PicoballoonLabs/Hardware-Resources/ATTRIBUTION.md

# Attribution

Symbols, footprints, templates, the color scheme and 3D models authored by
Noove s.r.o. are released under the MIT Licence (see [LICENSE](LICENSE)).

This repository also contains assets obtained from component suppliers and
third-party sources. These remain the property of their respective owners,
remain subject to their original terms, and are **not** relicensed here. The
MIT Licence applies only to the parts authored by Noove s.r.o.

The libraries were assembled over several years as a working design library,
and the origin of each individual file was not recorded. The table below lists
the known sources by category.

| Asset / library | Source | Terms |
|---|---|---|
| Some footprints in `Picoballoon ICs`, `Picoballoon Passives` and `Picoballoon Mechanical & Misc` (identifiable by a `kicad-footprint-generator` or KiCad library description) | [KiCad official libraries](https://www.kicad.org/libraries/) | CC-BY-SA 4.0 with the KiCad library exception |
| Some footprints and 3D models for LCSC-stocked parts | [EasyEDA / LCSC](https://easyeda.com/) | Original EasyEDA / LCSC terms |
| Some symbols, footprints and 3D models | [SnapMagic Search (SnapEDA)](https://www.snapeda.com/) | Original SnapMagic terms |
| Some symbols, footprints and 3D models | [Component Search Engine (SamacSys)](https://componentsearchengine.com/) | Original SamacSys terms |
| Some 3D models | [GrabCAD Community](https://grabcad.com/library) | Original terms of the respective GrabCAD author |
| 3D models of connectors, ICs and other catalogue parts | The respective component manufacturers (e.g. TE Connectivity, Molex, Hirose, Texas Instruments) and CAD portals such as TraceParts | Original manufacturer terms |
| `ONP1.2-37x54` solar panel model and footprints, power symbols, drawing sheet templates, color scheme, remaining symbols and footprints | Noove s.r.o. | MIT |

## Corrections and removal requests

If you are the owner of an asset in this repository and want it attributed
differently or removed, contact <hello@picoballoon.io> and it will be handled
promptly.
