PicoballoonLabs/Hardware-Resources/QFN-16.stp

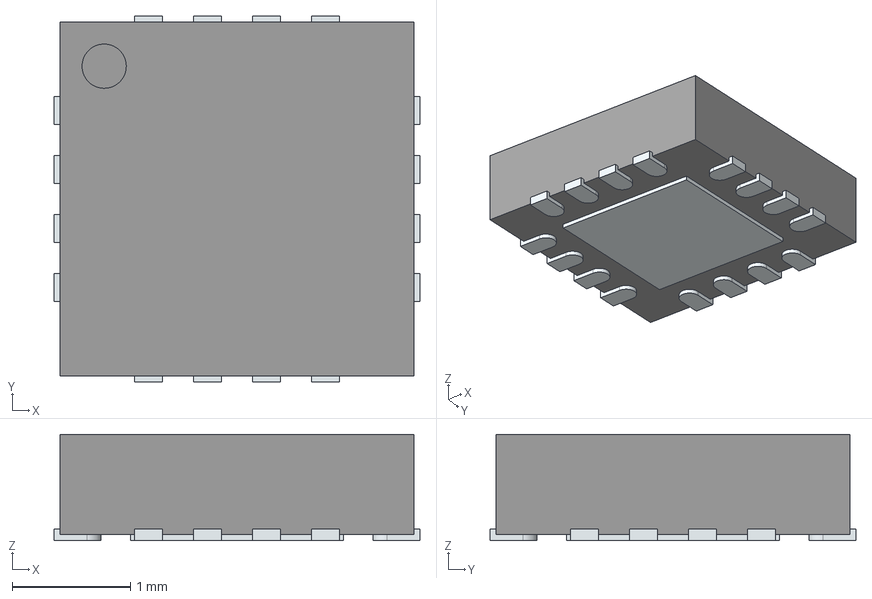
[picture p1: CAD file, 2024-07-15, last stored version]
QFN-16.stp
3.10 x 3.10 x 0.9 mm
ThermalPin
PinsArrayLR
PinsArrayTB
