PicoballoonLabs/Hardware-Resources/3D Models/VSON-HR-10.step

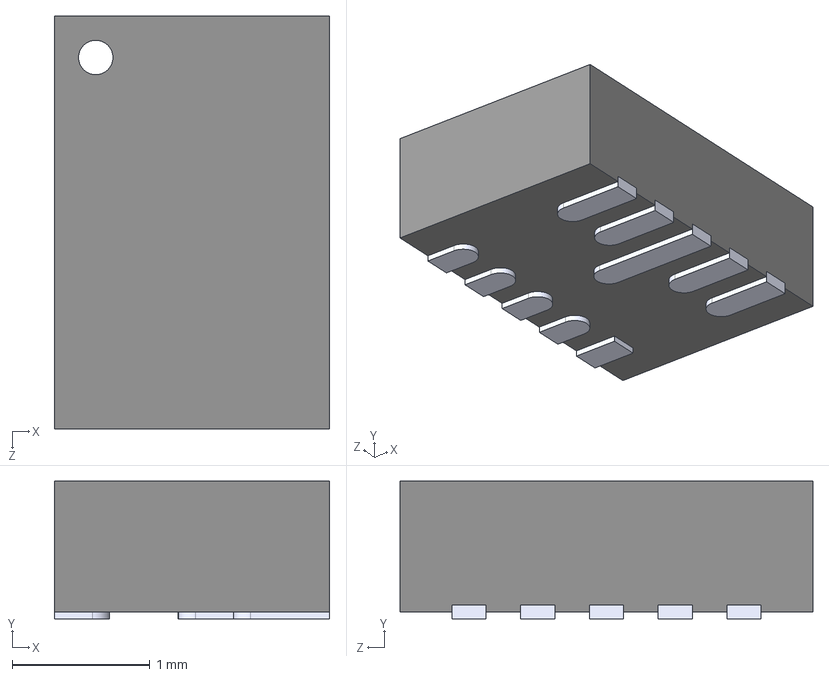
[picture p2: CAD file, 2025-07-29, last stored version]
3D Models/VSON-HR-10.step
2.00 x 1.00 x 3.00 mm
