PicoballoonLabs/Hardware-Resources/3D Models/Inductor 1620.stp

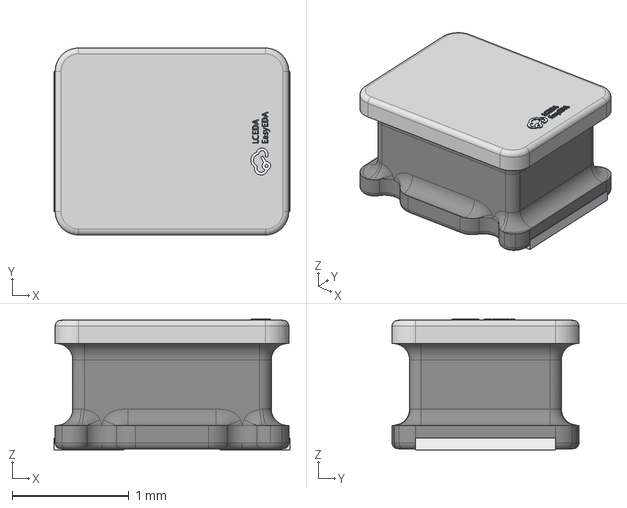
[picture p3: CAD file, 2025-07-29, last stored version]
3D Models/Inductor 1620.stp
2.02 x 1.60 x 1.12 mm
