PicoballoonLabs/Hardware-Resources/3D Models/Polyfuse 2920.STEP

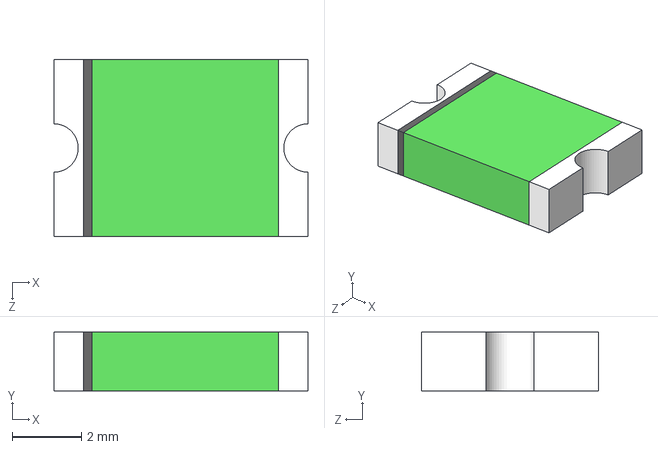
[picture p4: CAD file, 2025-07-21, last stored version]
3D Models/Polyfuse 2920.STEP
7.36 x 1.70 x 5.12 mm
