PicoballoonLabs/Hardware-Resources/3D Models/Polyfuse 1812.STEP

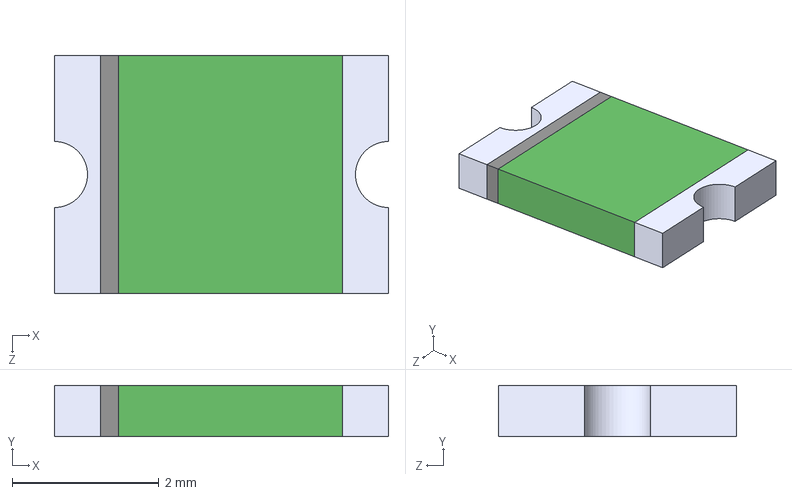
[picture p5: CAD file, 2025-07-21, last stored version]
3D Models/Polyfuse 1812.STEP
4.55 x 0.7 x 3.24 mm
