PicoballoonLabs/Hardware-Resources/3D Models/Fuse 1206.STEP

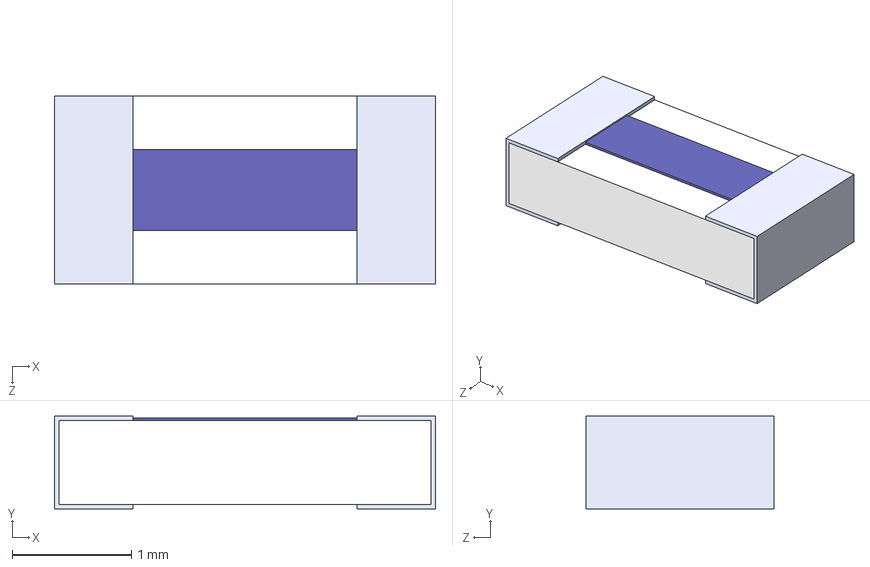
[picture p6: CAD file, 2025-07-21, last stored version]
3D Models/Fuse 1206.STEP
3.20 x 0.78 x 1.58 mm
