PicoballoonLabs/Hardware-Resources/3D Models/HPAK-7.step

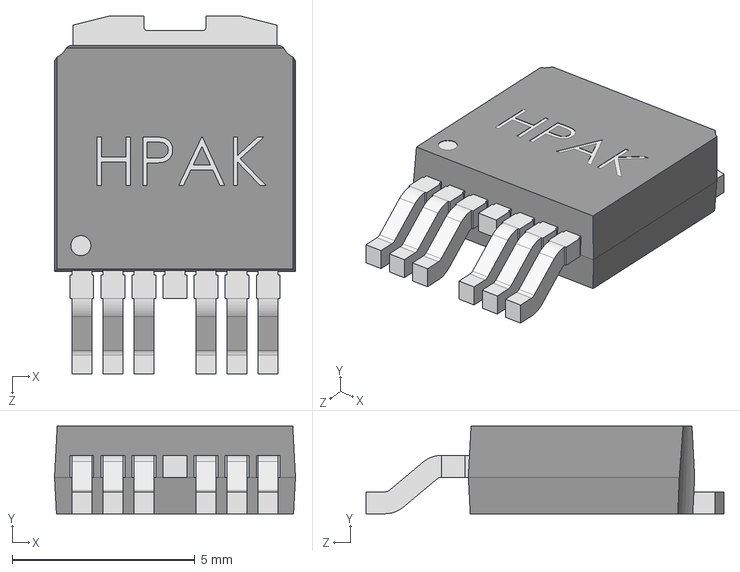
[picture p7: CAD file, 2025-07-18, last stored version]
3D Models/HPAK-7.step
6.60 x 2.40 x 9.80 mm
