PicoballoonLabs/Hardware-Resources/3D Models/WSCP-8.STEP

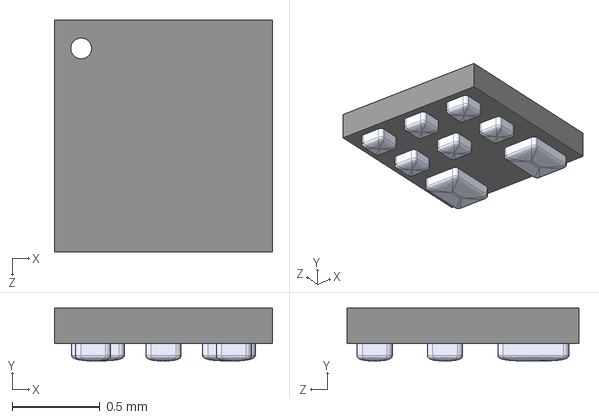
[picture p8: CAD file, 2025-07-18, last stored version]
3D Models/WSCP-8.STEP
1.24 x 0.3 x 1.32 mm
