PicoballoonLabs/Hardware-Resources/3D Models/Inductor 6466.stp

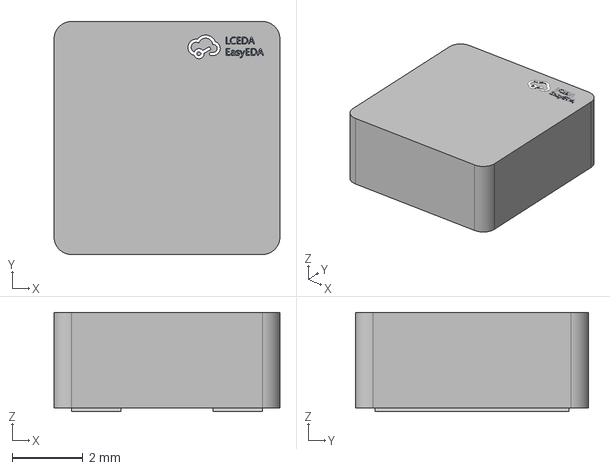
[picture p9: CAD file, 2025-07-18, last stored version]
3D Models/Inductor 6466.stp
6.40 x 6.60 x 2.81 mm
