PicoballoonLabs/Hardware-Resources/3D Models/VQFN-HR-10.step

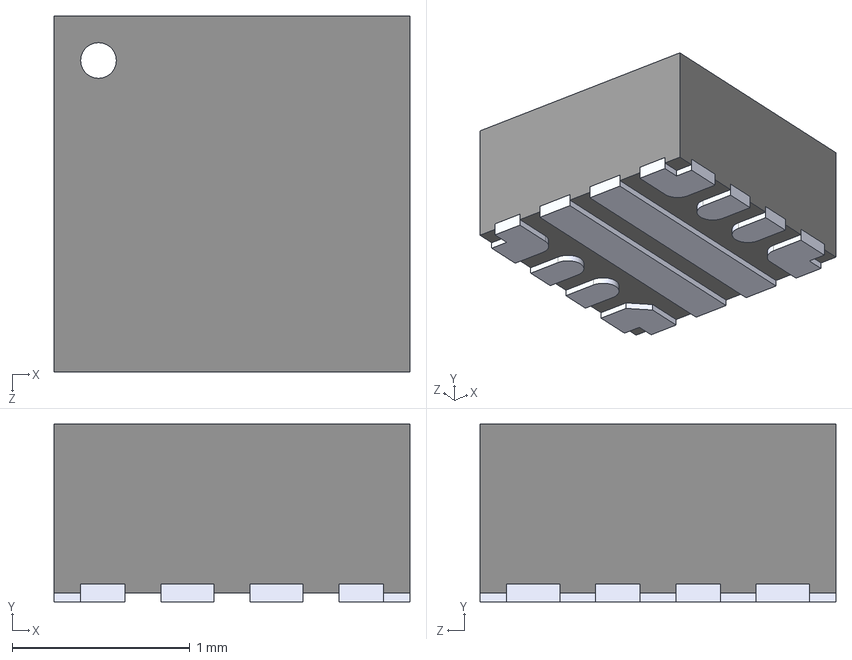
[picture p10: CAD file, 2025-07-18, last stored version]
3D Models/VQFN-HR-10.step
2.00 x 1.00 x 2.00 mm
