PicoballoonLabs/Hardware-Resources/3D Models/VFQFN-HR-11.STEP

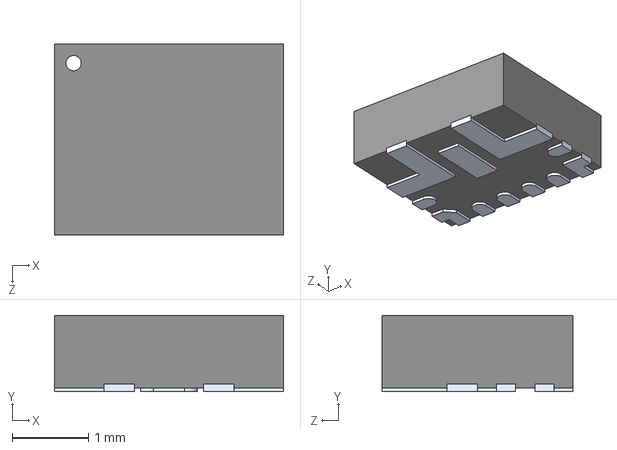
[picture p11: CAD file, 2025-07-18, last stored version]
3D Models/VFQFN-HR-11.STEP
3.00 x 1.00 x 2.50 mm
