PicoballoonLabs/Hardware-Resources/3D Models/Polyfuse 1210.STEP

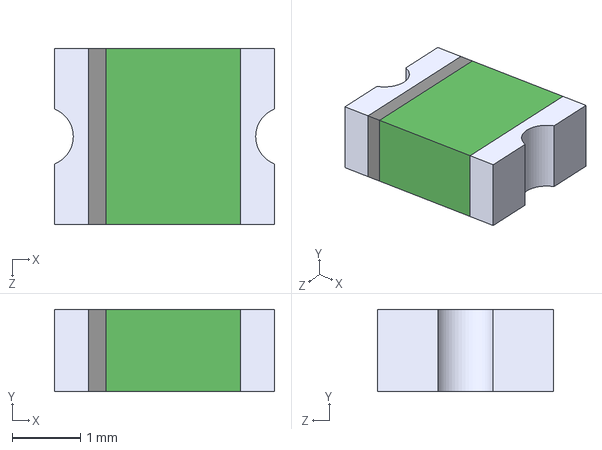
[picture p12: CAD file, 2025-07-18, last stored version]
3D Models/Polyfuse 1210.STEP
3.22 x 1.20 x 2.58 mm
