PicoballoonLabs/Hardware-Resources/3D Models/WAFER-XH2.54-2PWB.stp

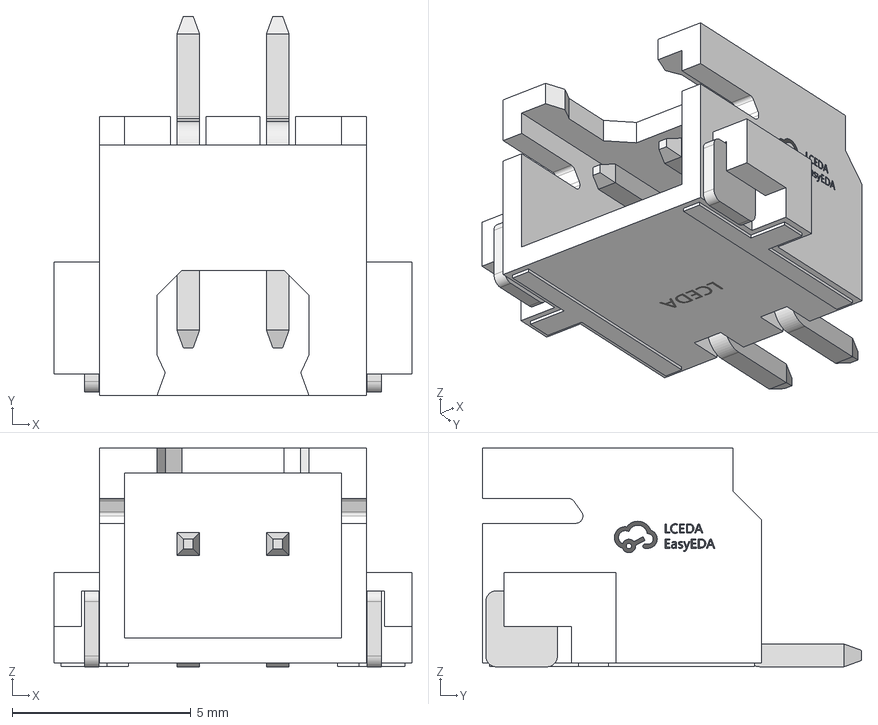
[picture p13: CAD file, 2025-07-18, last stored version]
3D Models/WAFER-XH2.54-2PWB.stp
10.00 x 10.6 x 6.11 mm
