PicoballoonLabs/Hardware-Resources/3D Models/Capacitor 6.3x5.9mm.STEP

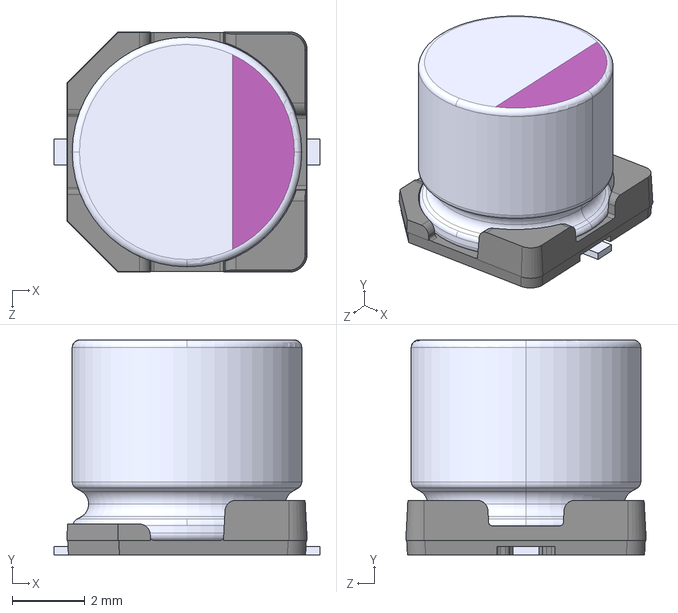
[picture p14: CAD file, 2025-06-23, last stored version]
3D Models/Capacitor 6.3x5.9mm.STEP
7.30 x 5.90 x 6.60 mm
