PicoballoonLabs/Hardware-Resources/3D Models/Polyfuse 2018.stp

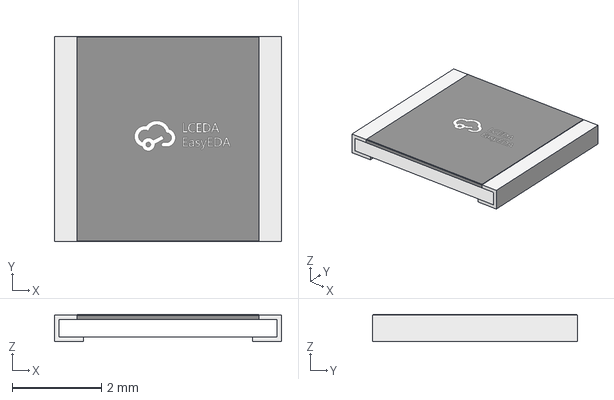
[picture p15: CAD file, 2025-06-23, last stored version]
3D Models/Polyfuse 2018.stp
5.10 x 4.60 x 0.611 mm
