PicoballoonLabs/Hardware-Resources/3D Models/DFN-6 2x2mm.stp

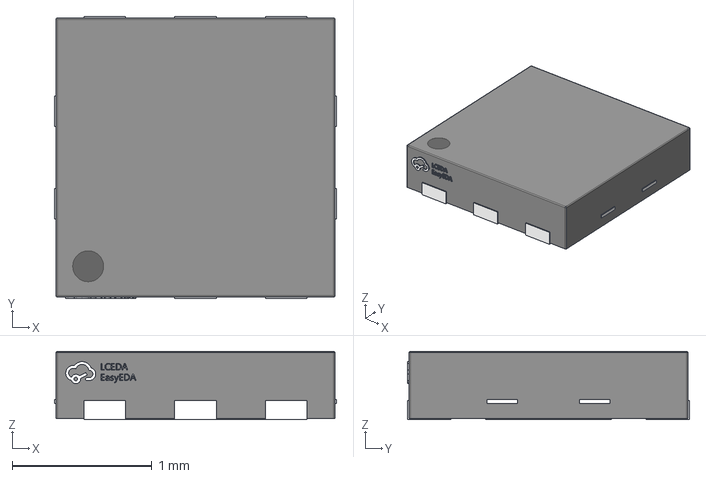
[picture p16: CAD file, 2025-06-23, last stored version]
3D Models/DFN-6 2x2mm.stp
2.02 x 2.02 x 0.49 mm
