PicoballoonLabs/Hardware-Resources/3D Models/QFN-16 4x4mm.step

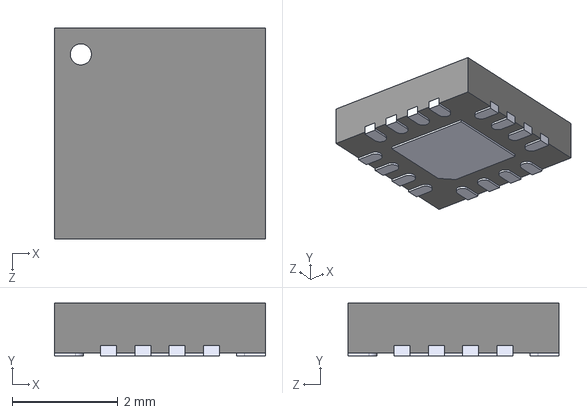
[picture p17: CAD file, 2025-06-23, last stored version]
3D Models/QFN-16 4x4mm.step
4.00 x 1.00 x 4.00 mm
