PicoballoonLabs/Hardware-Resources/3D Models/DC-005-5A-2.5-SMT.stp

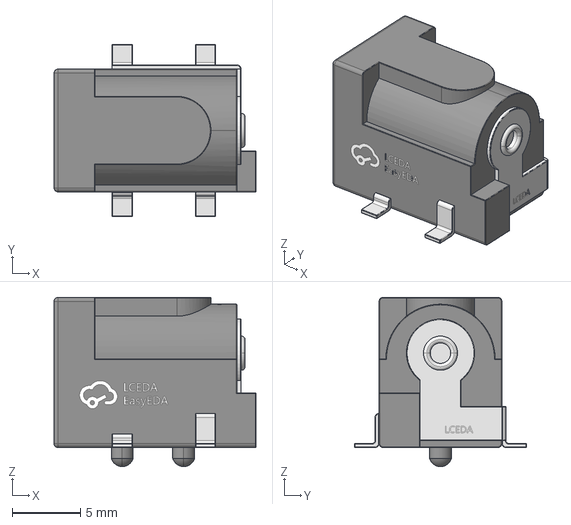
[picture p18: CAD file, 2025-06-23, last stored version]
3D Models/DC-005-5A-2.5-SMT.stp
14.8 x 12.6 x 12.4 mm
