PicoballoonLabs/Hardware-Resources/3D Models/WS2812B-MINI-X2.stp

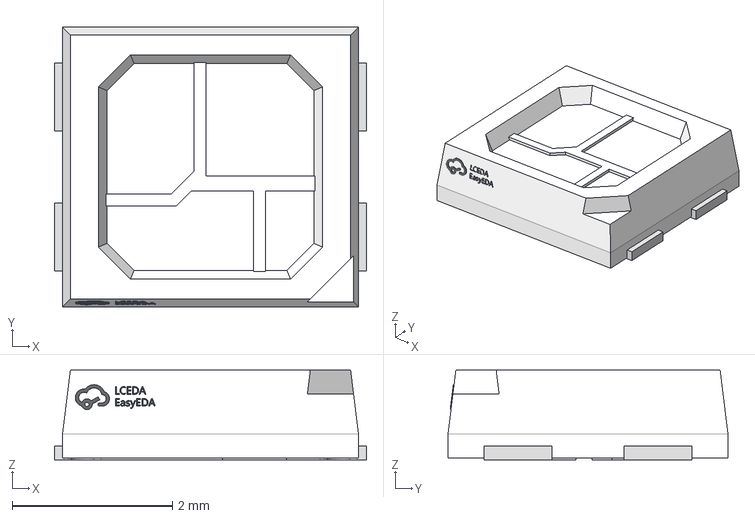
[picture p19: CAD file, 2025-06-23, last stored version]
3D Models/WS2812B-MINI-X2.stp
3.90 x 3.50 x 1.12 mm
