PicoballoonLabs/Hardware-Resources/3D Models/Polyfuse 1206.STEP

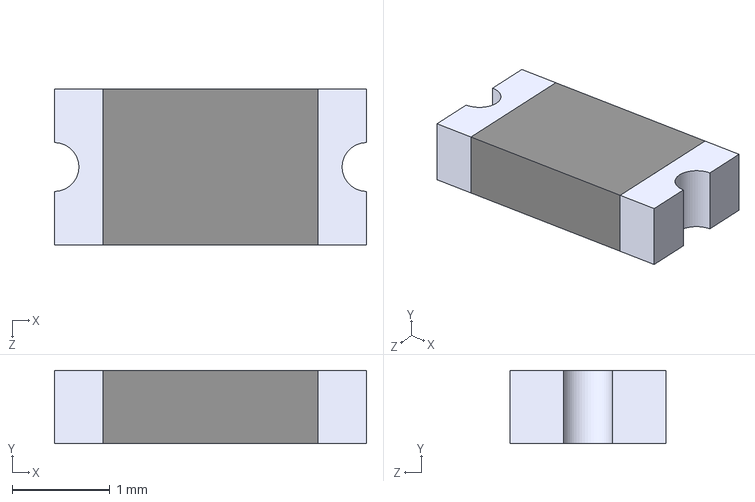
[picture p20: CAD file, 2025-06-23, last stored version]
3D Models/Polyfuse 1206.STEP
3.20 x 0.75 x 1.60 mm
