PicoballoonLabs/Hardware-Resources/3D Models/Inductor 5553.stp

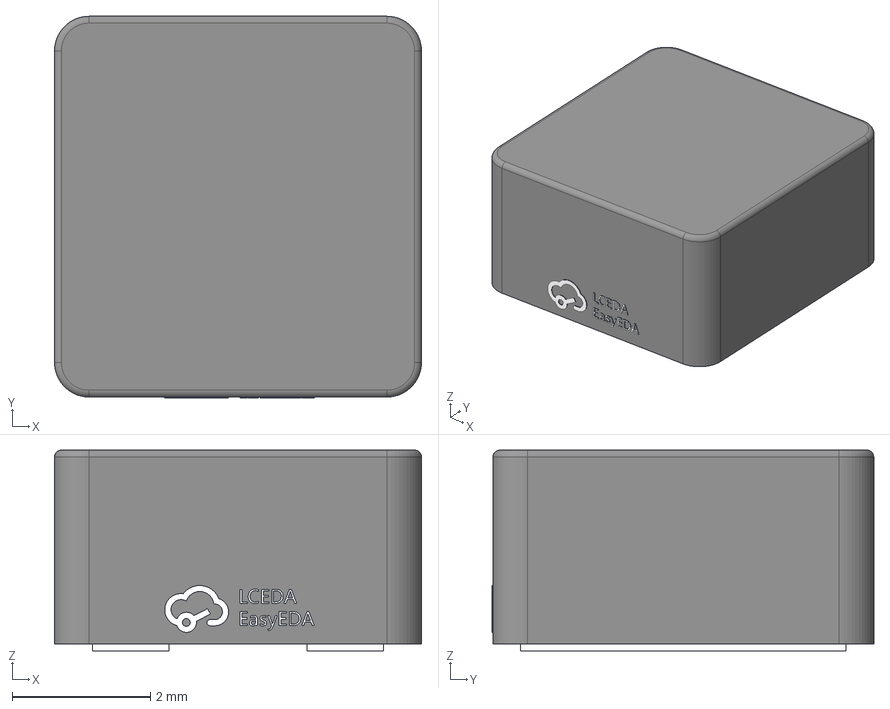
[picture p21: CAD file, 2025-06-23, last stored version]
3D Models/Inductor 5553.stp
5.30 x 5.51 x 2.90 mm
