PicoballoonLabs/Hardware-Resources/3D Models/Inductor 3x3mm.stp

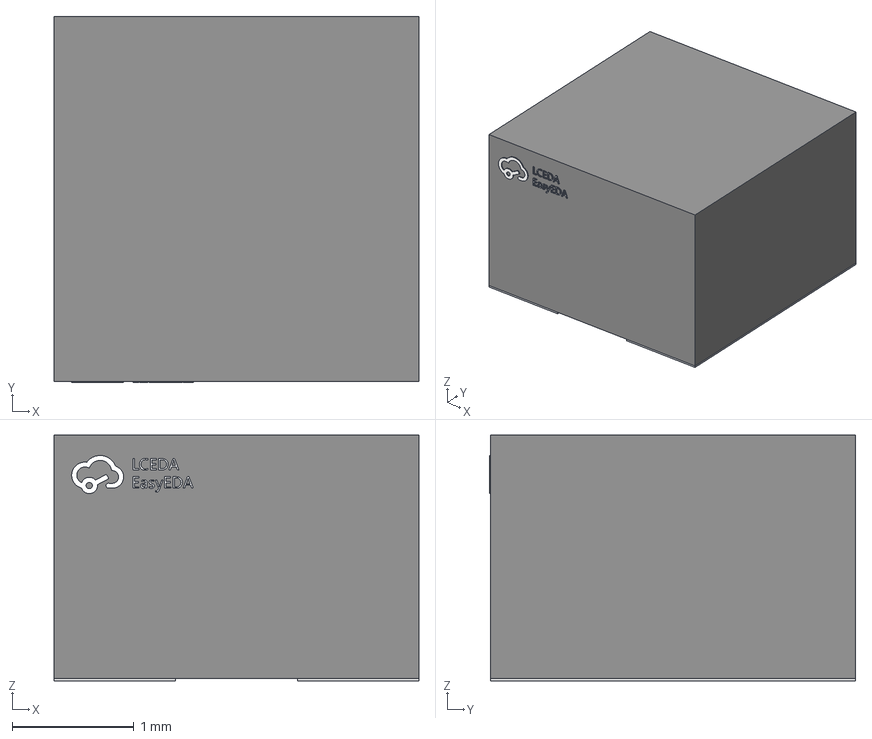
[picture p22: CAD file, 2025-04-17, last stored version]
3D Models/Inductor 3x3mm.stp
3.00 x 3.01 x 2.02 mm
