PicoballoonLabs/Hardware-Resources/3D Models/XT60PW-F.STEP

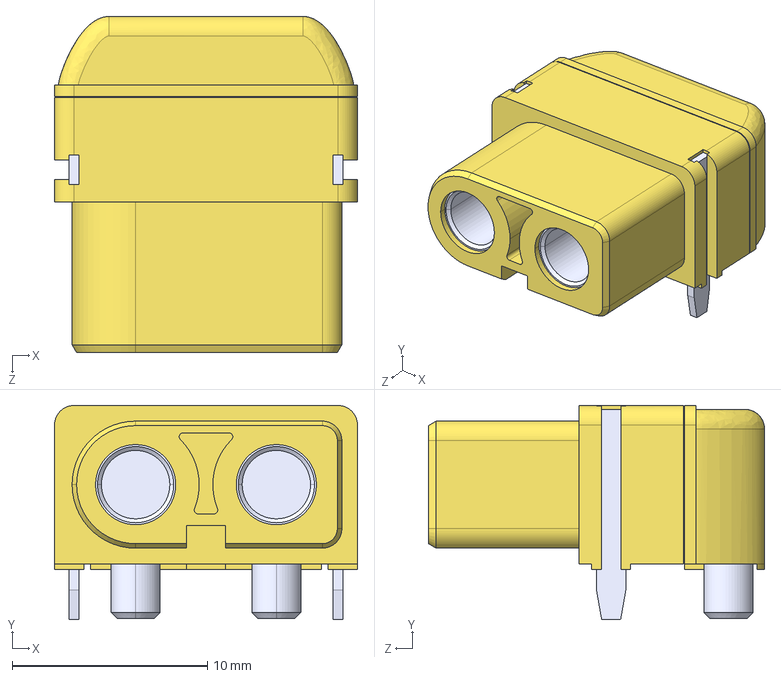
[picture p23: CAD file, 2025-04-14, last stored version]
3D Models/XT60PW-F.STEP
15.5 x 10.9 x 17.2 mm
