PicoballoonLabs/Hardware-Resources/3D Models/B2B YXT-BB10-10P-02.stp

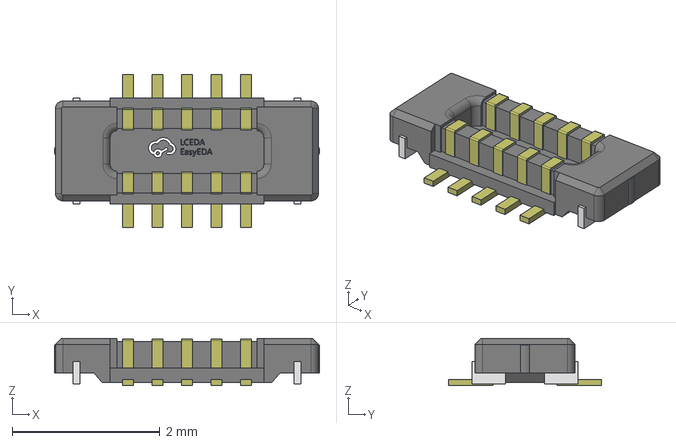
[picture p24: CAD file, 2025-04-09, last stored version]
3D Models/B2B YXT-BB10-10P-02.stp
3.59 x 2.07 x 0.64 mm
