PicoballoonLabs/Hardware-Resources/3D Models/Inductor 1008.stp

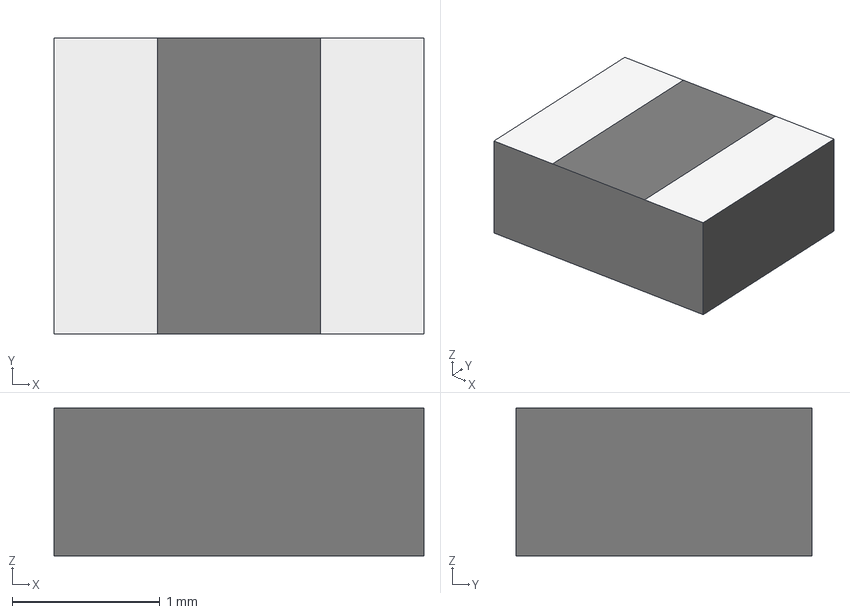
[picture p26: CAD file, 2025-04-09, last stored version]
3D Models/Inductor 1008.stp
2.50 x 2.00 x 1.00 mm
body_SSMC_252010
land_pattern_SSMC_252010 x 2
