PicoballoonLabs/Hardware-Resources/3D Models/B2B GT-B0353MSV04-06B0201.stp

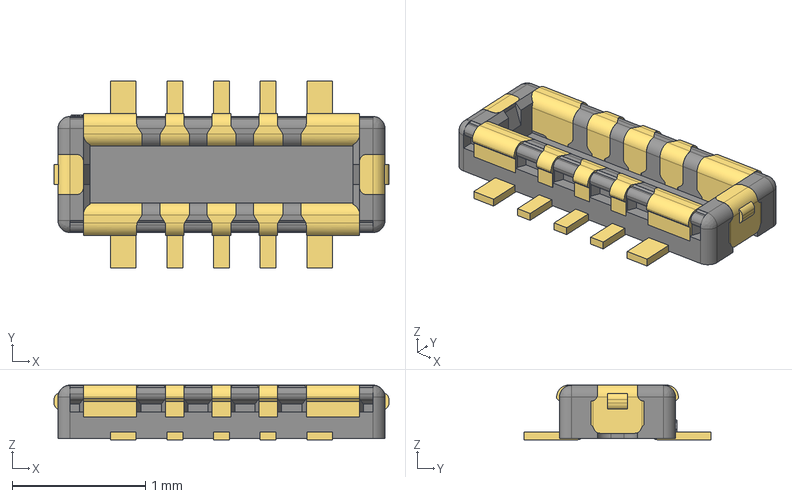
[picture p27: CAD file, 2025-04-09, last stored version]
3D Models/B2B GT-B0353MSV04-06B0201.stp
2.51 x 1.40 x 0.411 mm
