PicoballoonLabs/Hardware-Resources/3D Models/B2B GT-B0353FSV06-08B0201.stp

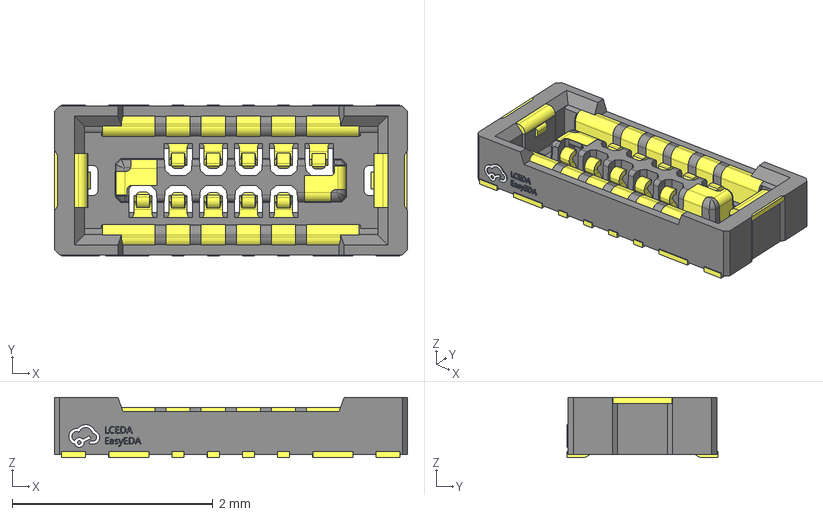
[picture p28: CAD file, 2025-04-07, last stored version]
3D Models/B2B GT-B0353FSV06-08B0201.stp
3.51 x 1.50 x 0.601 mm
