PicoballoonLabs/Hardware-Resources/3D Models/MOLEX 532610271.STEP

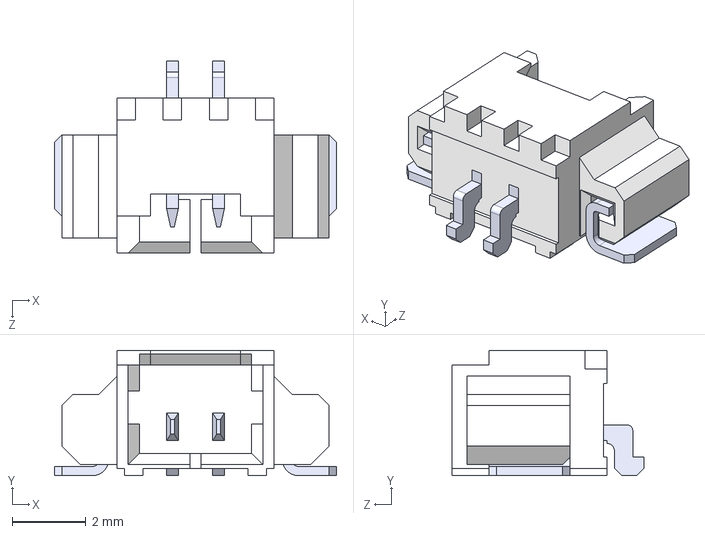
[picture p29: CAD file, 2025-04-07, last stored version]
3D Models/MOLEX 532610271.STEP
7.65 x 3.40 x 5.20 mm
