PicoballoonLabs/Hardware-Resources/3D Models/B2B GT-B0353FSV06-06B0201.stp

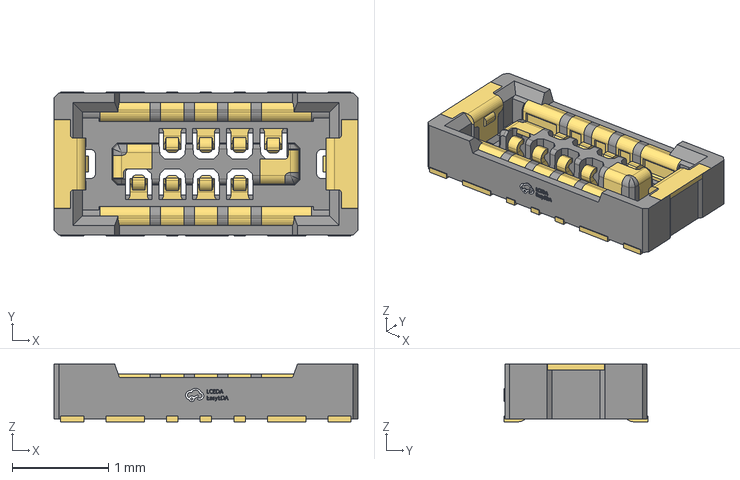
[picture p30: CAD file, 2025-04-07, last stored version]
3D Models/B2B GT-B0353FSV06-06B0201.stp
3.16 x 1.50 x 0.6 mm
