PicoballoonLabs/Hardware-Resources/3D Models/FPC-05F-10PH20.stp

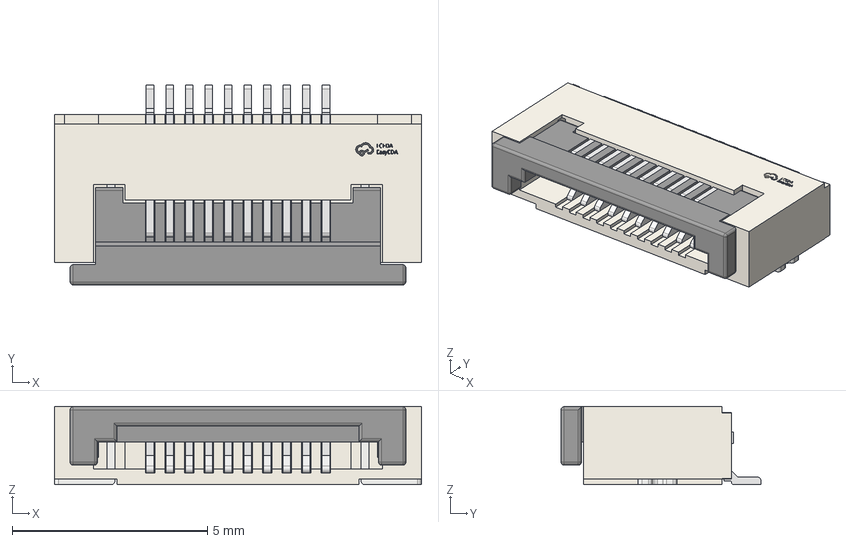
[picture p31: CAD file, 2025-04-07, last stored version]
3D Models/FPC-05F-10PH20.stp
9.40 x 5.12 x 2.01 mm
