PicoballoonLabs/Hardware-Resources/3D Models/B2B YXT YXT-BB10-10S-02.STEP

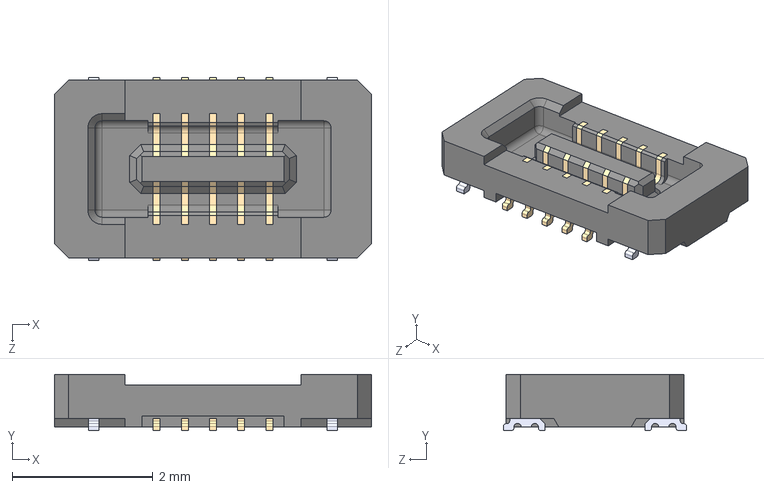
[picture p32: CAD file, 2025-04-07, last stored version]
3D Models/B2B YXT YXT-BB10-10S-02.STEP
4.50 x 0.8 x 2.60 mm
