PicoballoonLabs/Hardware-Resources/3D Models/Inductor 7678.stp

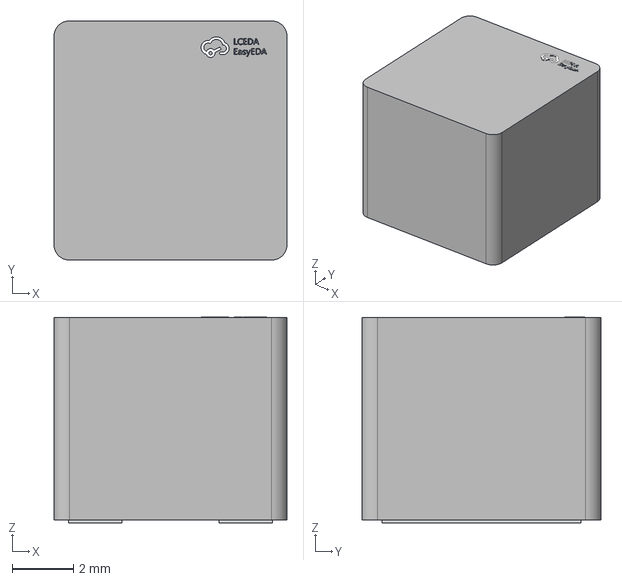
[picture p33: CAD file, 2025-04-04, last stored version]
3D Models/Inductor 7678.stp
7.60 x 7.80 x 6.71 mm
