PicoballoonLabs/Hardware-Resources/3D Models/VQFN-11.STEP

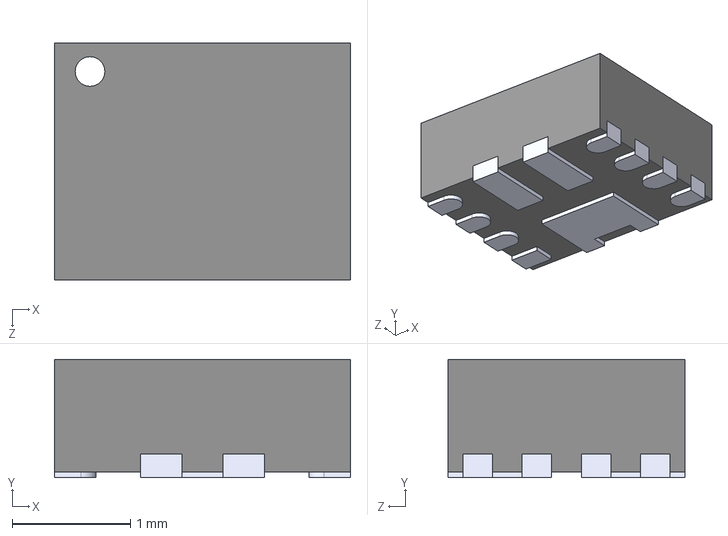
[picture p34: CAD file, 2025-04-04, last stored version]
3D Models/VQFN-11.STEP
2.50 x 1.00 x 2.00 mm
