PicoballoonLabs/Hardware-Resources/3D Models/LED WS2816B-2121.STEP

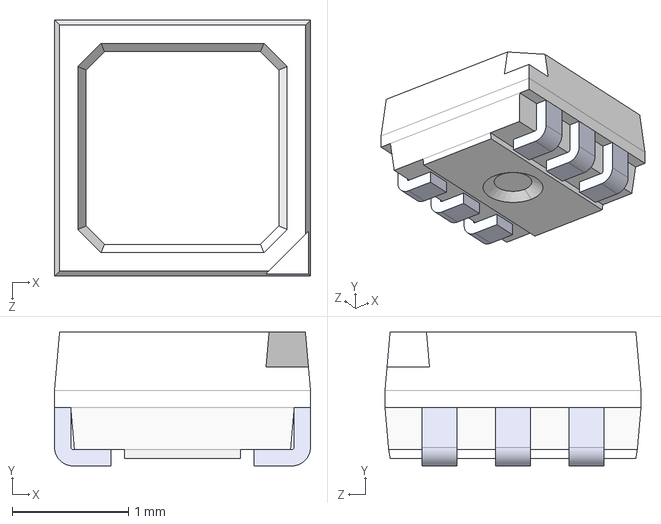
[picture p35: CAD file, 2025-04-03, last stored version]
3D Models/LED WS2816B-2121.STEP
2.20 x 1.15 x 2.20 mm
