PicoballoonLabs/Hardware-Resources/3D Models/Button GT_TC029B-H025-L1N.stp

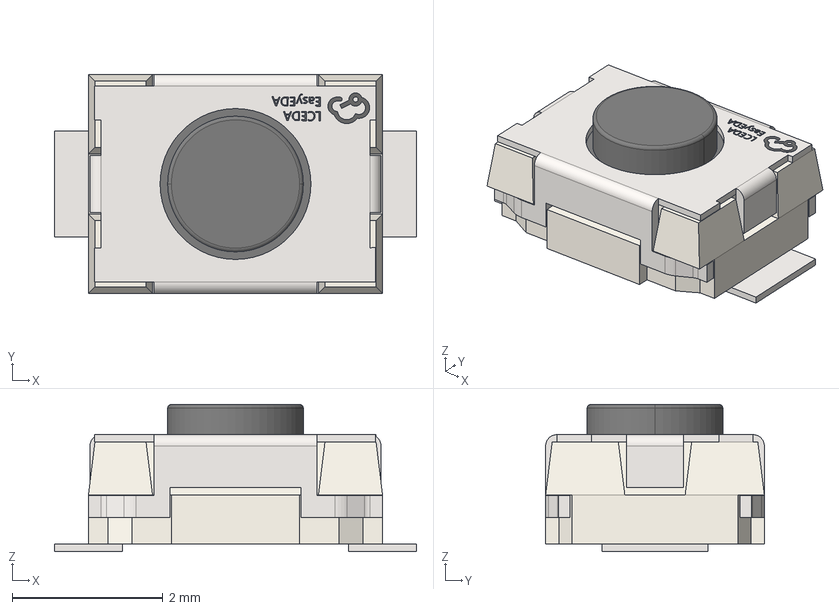
[picture p36: CAD file, 2025-04-03, last stored version]
3D Models/Button GT_TC029B-H025-L1N.stp
4.80 x 2.90 x 1.95 mm
