PicoballoonLabs/Hardware-Resources/3D Models/LED WS2813B-MINI-V1.STEP

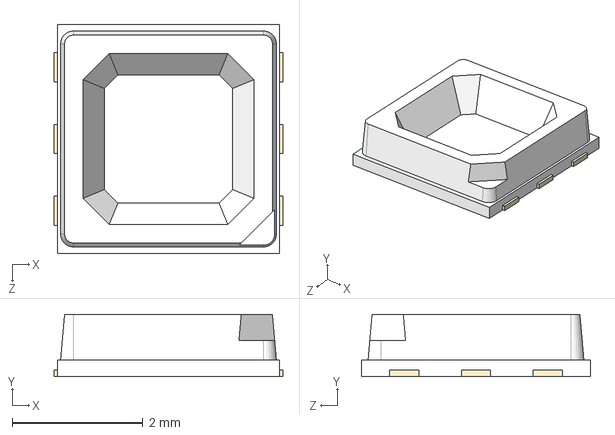
[picture p37: CAD file, 2025-04-03, last stored version]
3D Models/LED WS2813B-MINI-V1.STEP
3.50 x 0.95 x 3.50 mm
