PicoballoonLabs/Hardware-Resources/3D Models/VFQFN-29.STEP

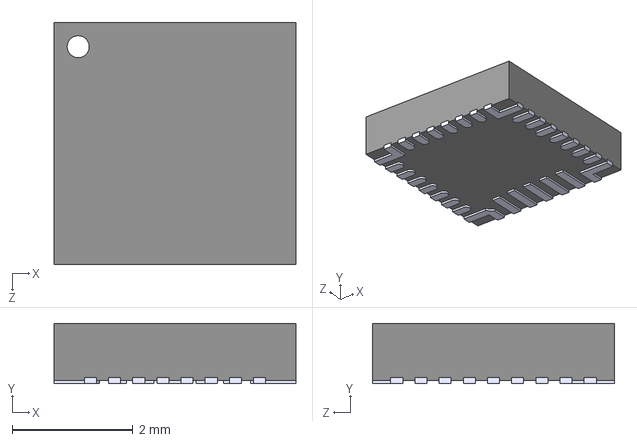
[picture p38: CAD file, 2025-04-03, last stored version]
3D Models/VFQFN-29.STEP
4.00 x 1.00 x 4.00 mm
