PicoballoonLabs/Hardware-Resources/3D Models/Battery holder BH-18650-B1BA002.stp

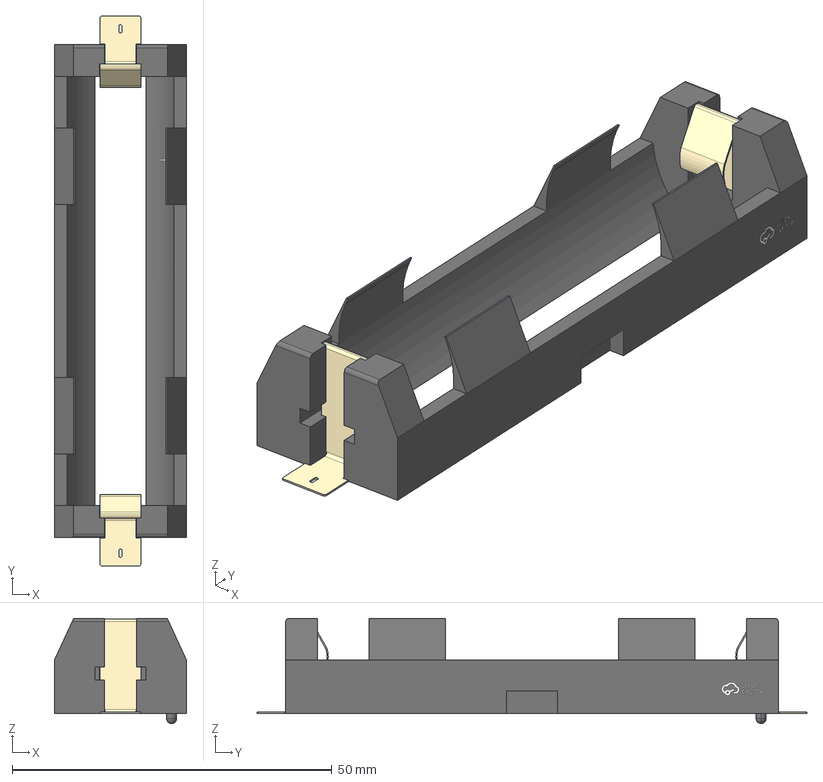
[picture p39: CAD file, 2025-04-03, last stored version]
3D Models/Battery holder BH-18650-B1BA002.stp
20.7 x 86.0 x 16.5 mm
