PicoballoonLabs/Hardware-Resources/3D Models/VSON-10 3x3mm.STEP

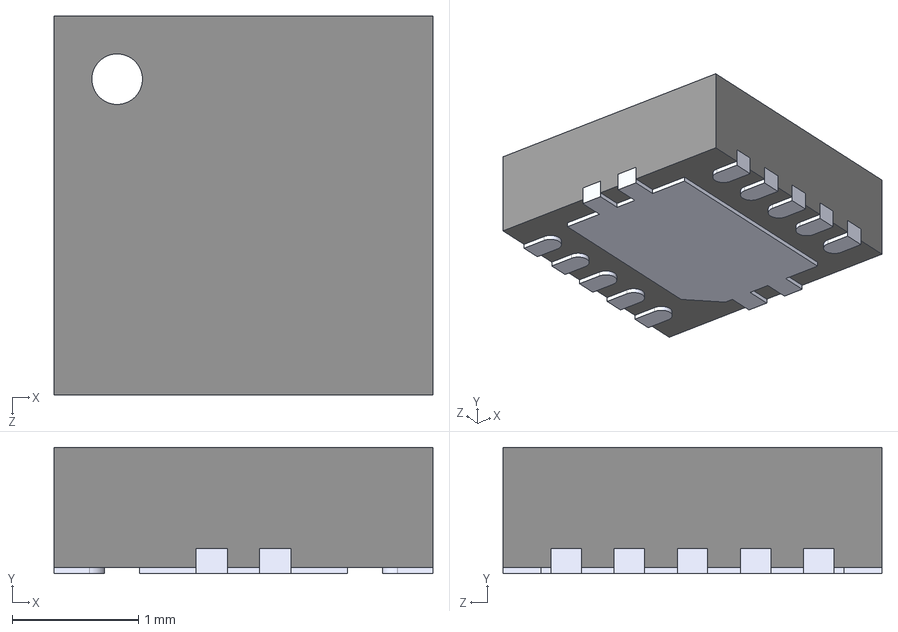
[picture p40: CAD file, 2025-04-03, last stored version]
3D Models/VSON-10 3x3mm.STEP
3.00 x 1.00 x 3.00 mm
