PicoballoonLabs/Hardware-Resources/3D Models/MM8030-2610RK0.step

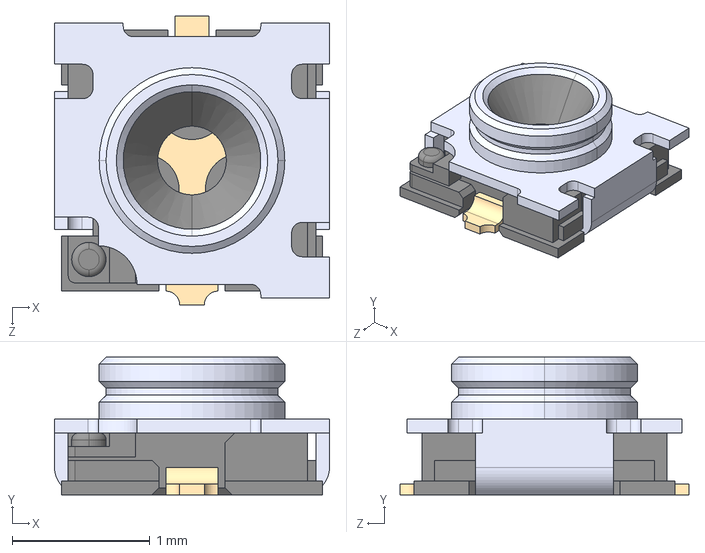
[picture p41: CAD file, 2025-02-13, last stored version]
3D Models/MM8030-2610RK0.step
2.00 x 1.00 x 2.10 mm
