PicoballoonLabs/Hardware-Resources/3D Models/BWSMA-KE-P001.stp

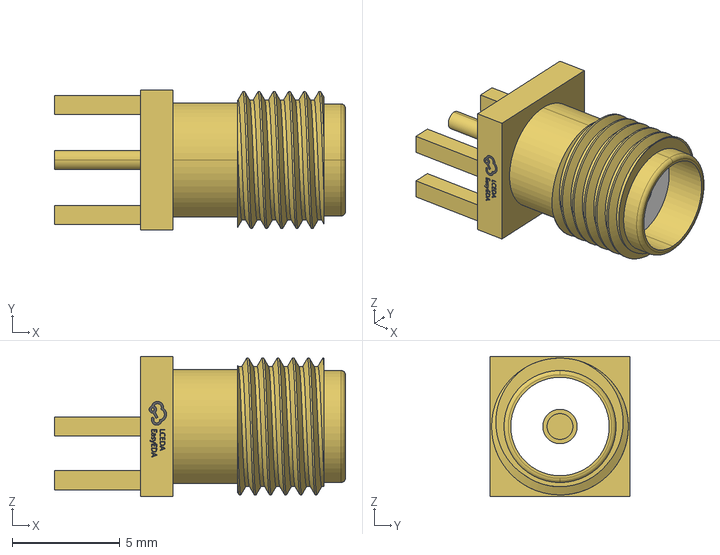
[picture p42: CAD file, 2024-12-27, last stored version]
3D Models/BWSMA-KE-P001.stp
13.5 x 6.50 x 6.50 mm
