PicoballoonLabs/Hardware-Resources/3D Models/SMA_EDGE.step

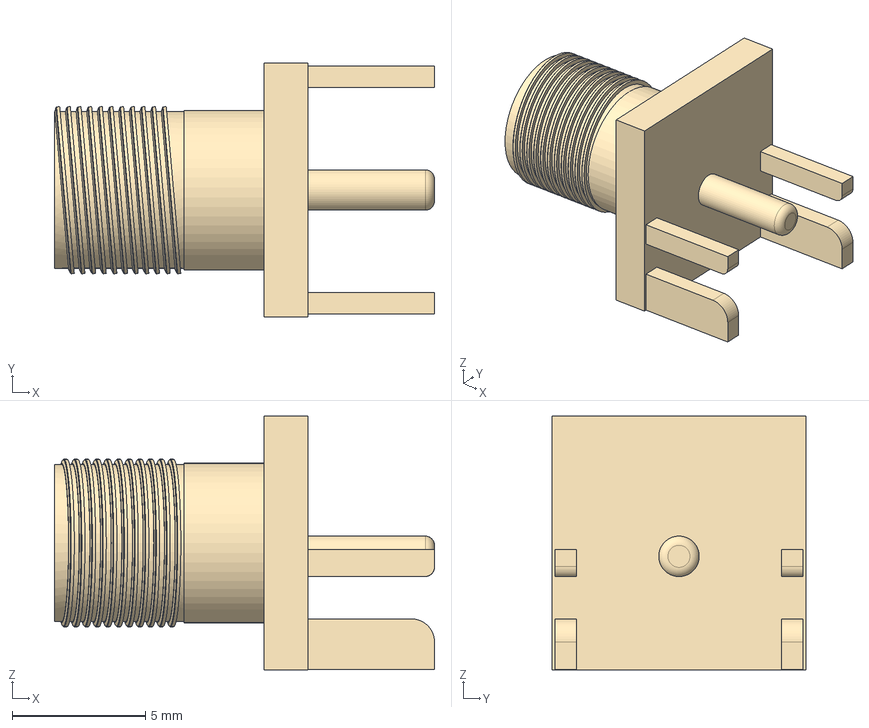
[picture p43: CAD file, 2024-11-05, last stored version]
3D Models/SMA_EDGE.step
14.3 x 9.52 x 9.52 mm
