PicoballoonLabs/Hardware-Resources/3D Models/Diode SMB.step

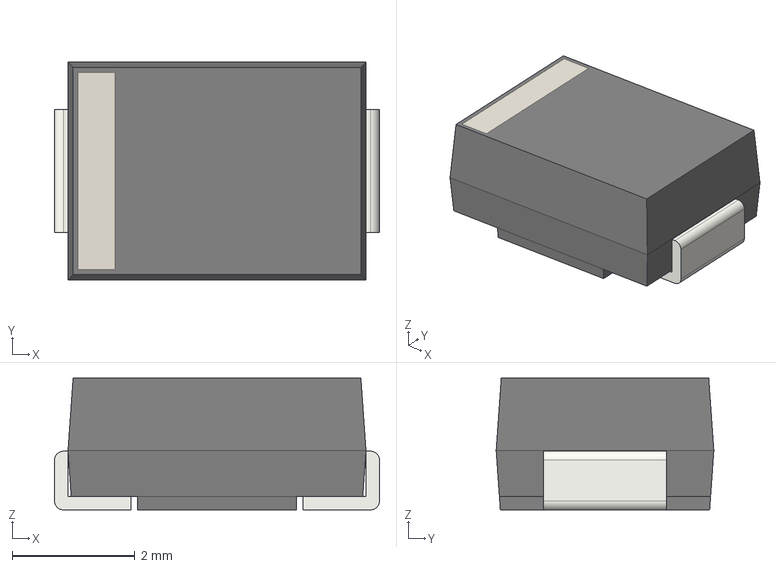
[picture p44: CAD file, 2024-11-05, last stored version]
3D Models/Diode SMB.step
5.30 x 3.55 x 2.15 mm
