PicoballoonLabs/Hardware-Resources/3D Models/WAFER-XH2.54-4PWB.stp

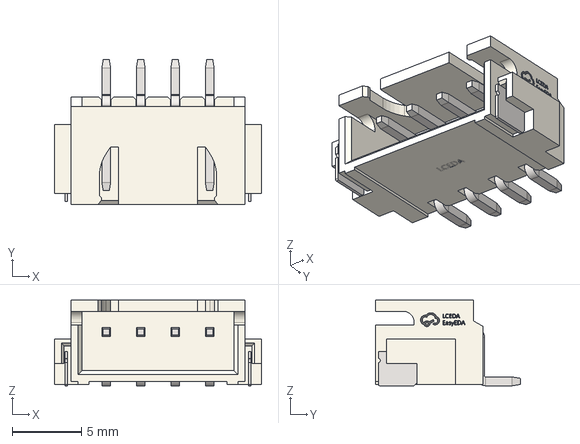
[picture p45: CAD file, 2024-11-05, last stored version]
3D Models/WAFER-XH2.54-4PWB.stp
15.0 x 10.5 x 6.20 mm
