PicoballoonLabs/Hardware-Resources/3D Models/NRF9161.STEP

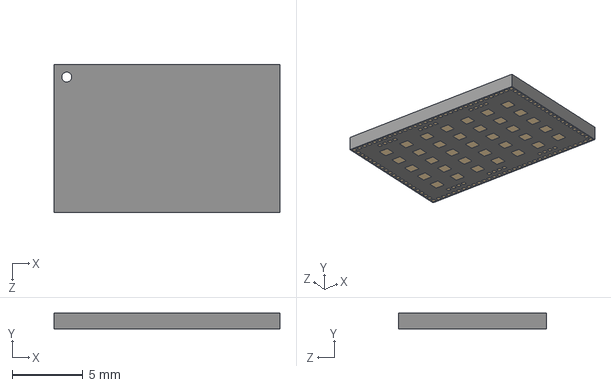
[picture p46: CAD file, 2024-11-04, last stored version]
3D Models/NRF9161.STEP
16.0 x 1.10 x 10.5 mm
