PicoballoonLabs/Hardware-Resources/3D Models/Inductor 0201.STEP

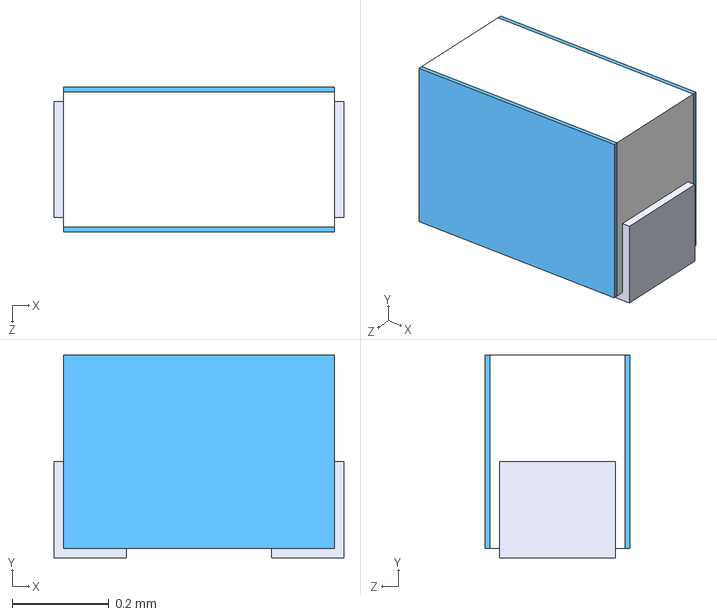
[picture p47: CAD file, 2024-11-04, last stored version]
3D Models/Inductor 0201.STEP
0.6 x 0.42 x 0.3 mm
