PicoballoonLabs/Hardware-Resources/3D Models/X2-DFN1010-3.stp

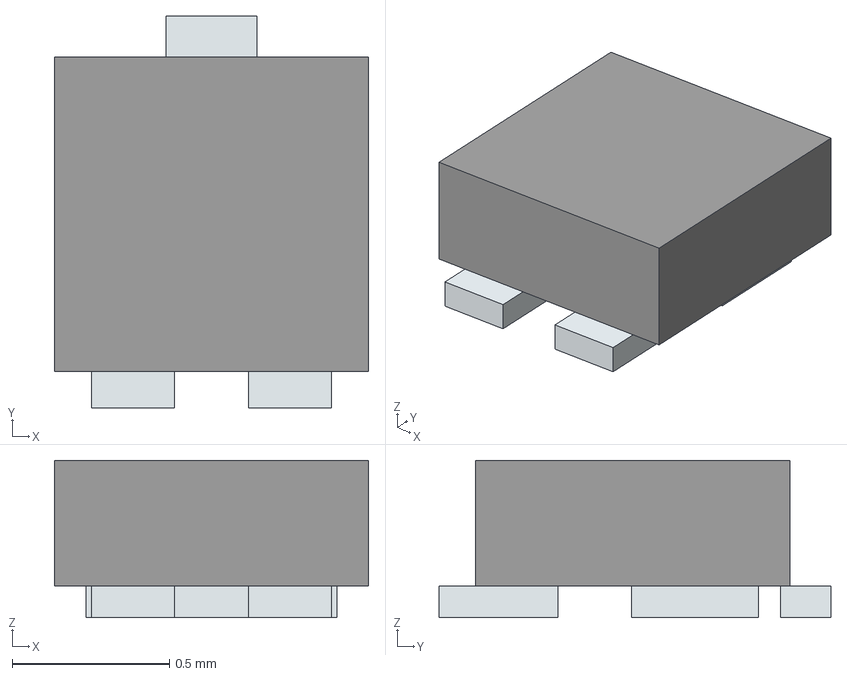
[picture p48: CAD file, 2024-10-10, last stored version]
3D Models/X2-DFN1010-3.stp
1.00 x 1.25 x 0.5 mm
Pins
