PicoballoonLabs/Hardware-Resources/3D Models/SWD 2x5 Box Connector.step

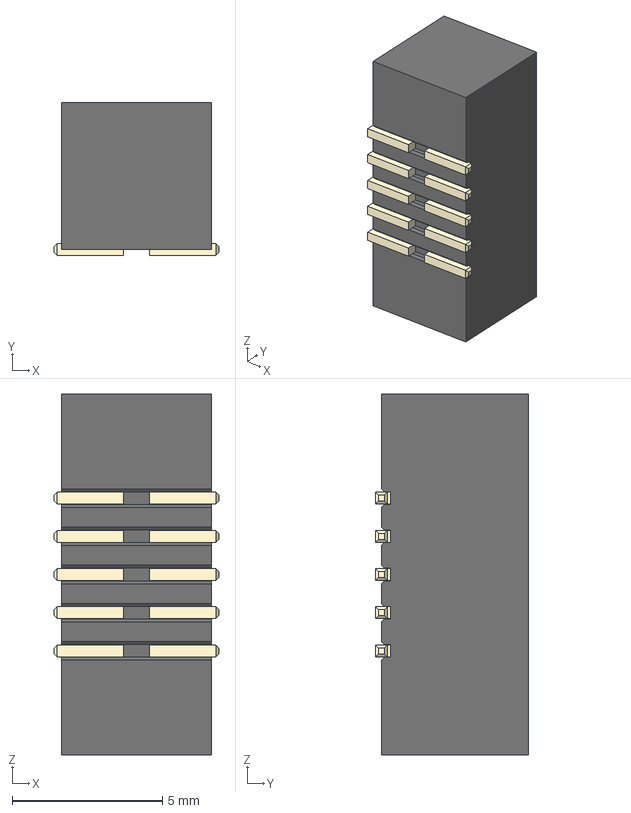
[picture p49: CAD file, 2024-10-08, last stored version]
3D Models/SWD 2x5 Box Connector.step
5.47 x 5.10 x 12.0 mm
