PicoballoonLabs/Hardware-Resources/3D Models/SWD 2x5 Mini Connector.step

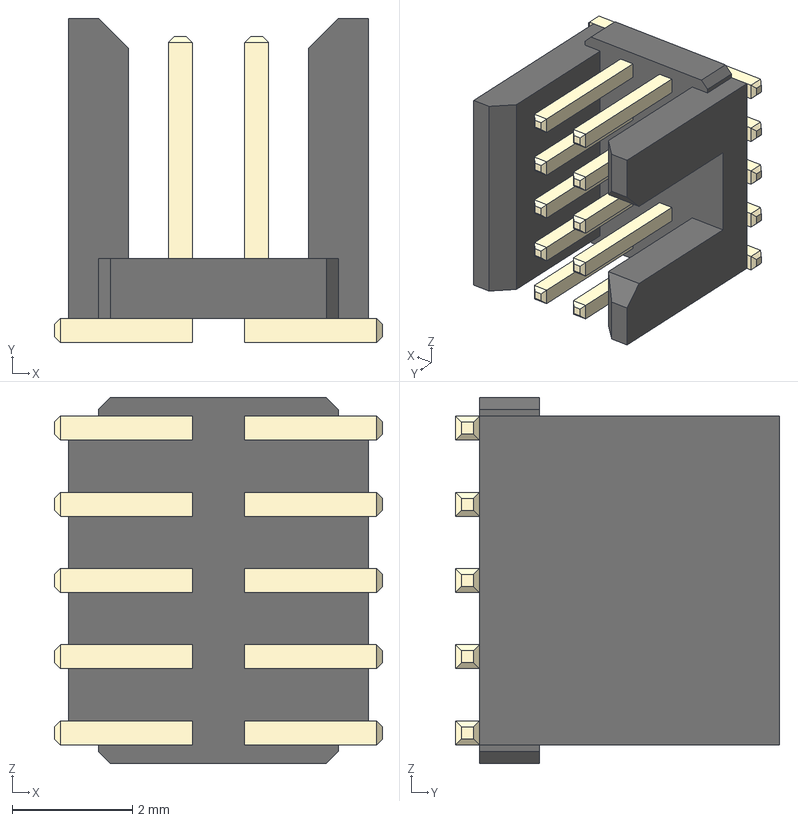
[picture p50: CAD file, 2024-10-08, last stored version]
3D Models/SWD 2x5 Mini Connector.step
5.47 x 5.40 x 6.10 mm
