PicoballoonLabs/Hardware-Resources/3D Models/TSDSON-8.STEP

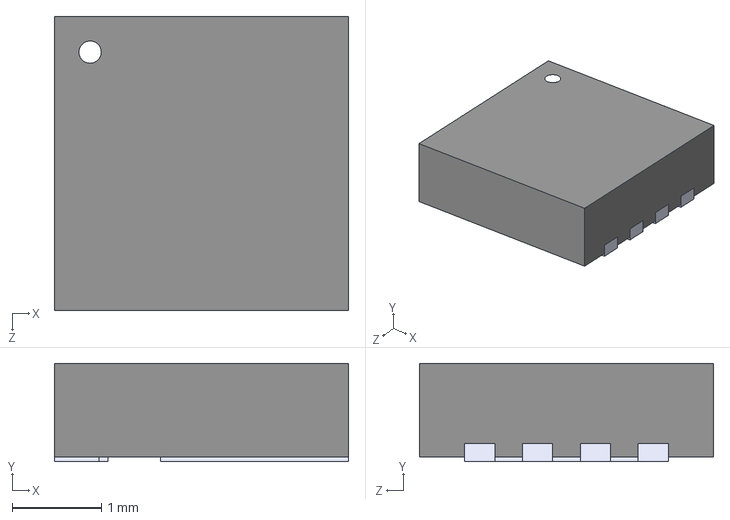
[picture p51: CAD file, 2024-10-06, last stored version]
3D Models/TSDSON-8.STEP
3.30 x 1.10 x 3.30 mm
