PicoballoonLabs/Hardware-Resources/3D Models/B2B-XH-A (LF)(SN).STEP

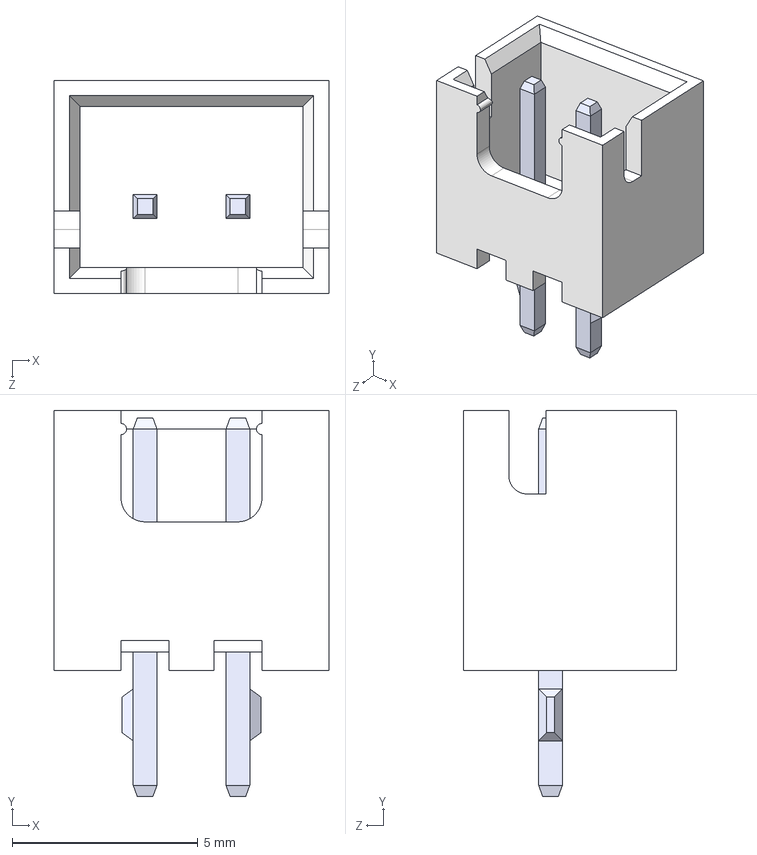
[picture p52: CAD file, 2024-10-06, last stored version]
3D Models/B2B-XH-A (LF)(SN).STEP
7.40 x 10.4 x 5.75 mm
