PicoballoonLabs/Hardware-Resources/3D Models/WSON-10 2x2mm.stp

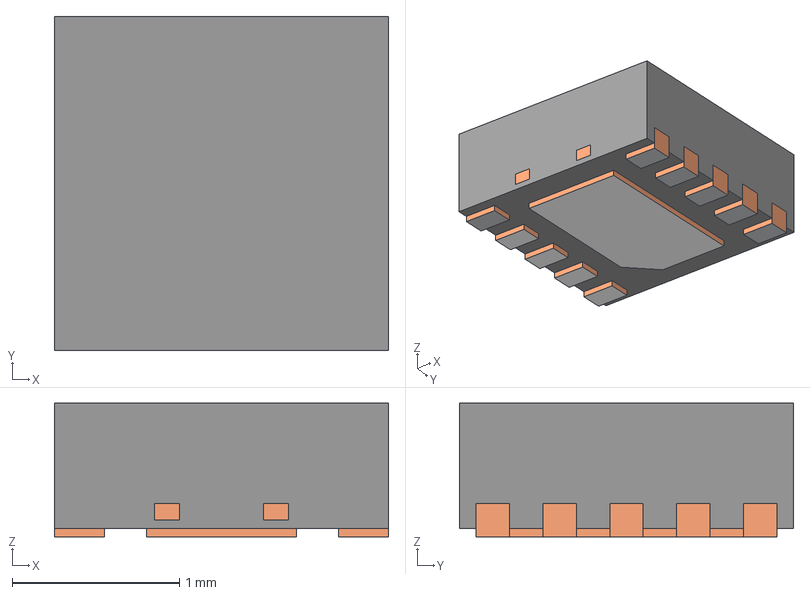
[picture p53: CAD file, 2024-10-06, last stored version]
3D Models/WSON-10 2x2mm.stp
2.00 x 2.00 x 0.8 mm
BODY-SON
FRAME-DSQ0010A
PIN1-ID
