PicoballoonLabs/Hardware-Resources/3D Models/UQFN-10.stp

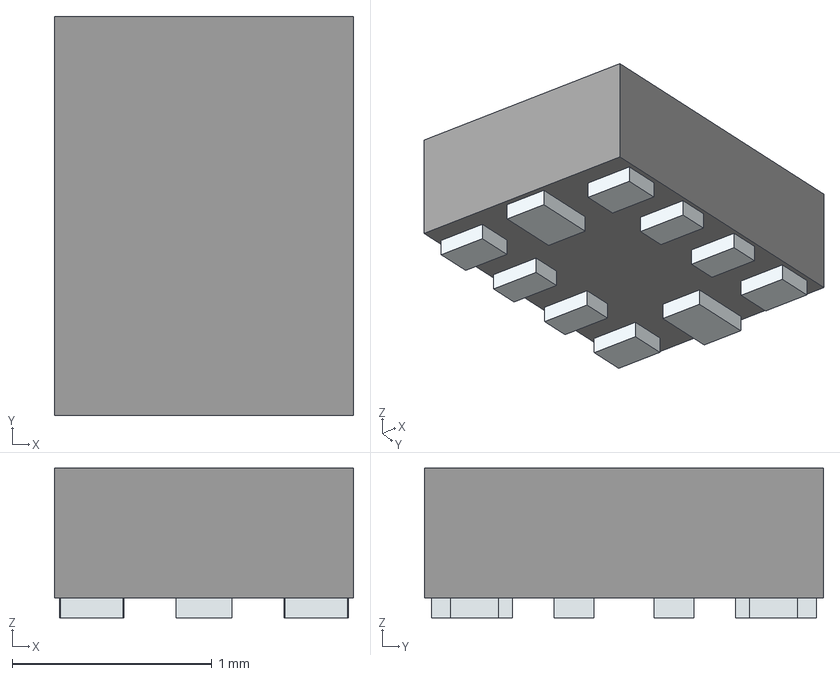
[picture p54: CAD file, 2024-10-03, last stored version]
3D Models/UQFN-10.stp
1.50 x 2.00 x 0.75 mm
Pins
