PicoballoonLabs/Hardware-Resources/3D Models/TSNP-6-10.step

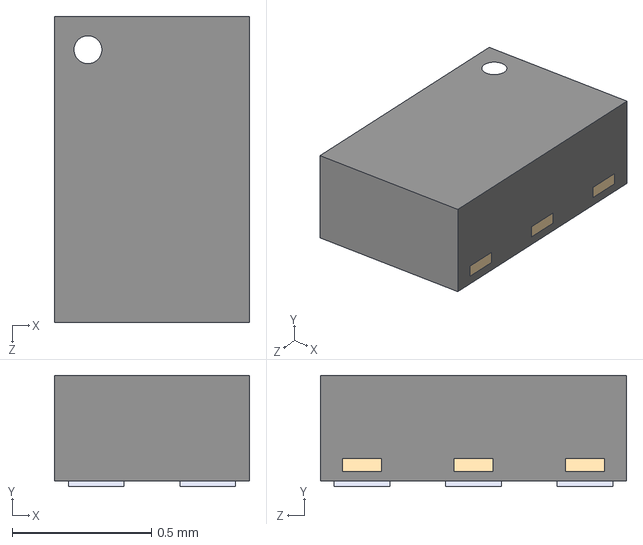
[picture p55: CAD file, 2024-08-12, last stored version]
3D Models/TSNP-6-10.step
0.7 x 0.4 x 1.10 mm
