PicoballoonLabs/Hardware-Resources/3D Models/Diode 0201.STEP

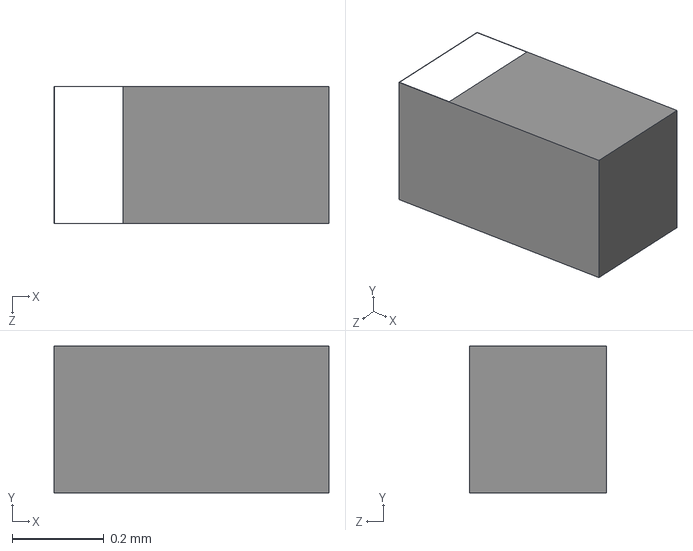
[picture p56: CAD file, 2024-08-12, last stored version]
3D Models/Diode 0201.STEP
0.6 x 0.32 x 0.3 mm
