PicoballoonLabs/Hardware-Resources/3D Models/DSBGA-6.STEP

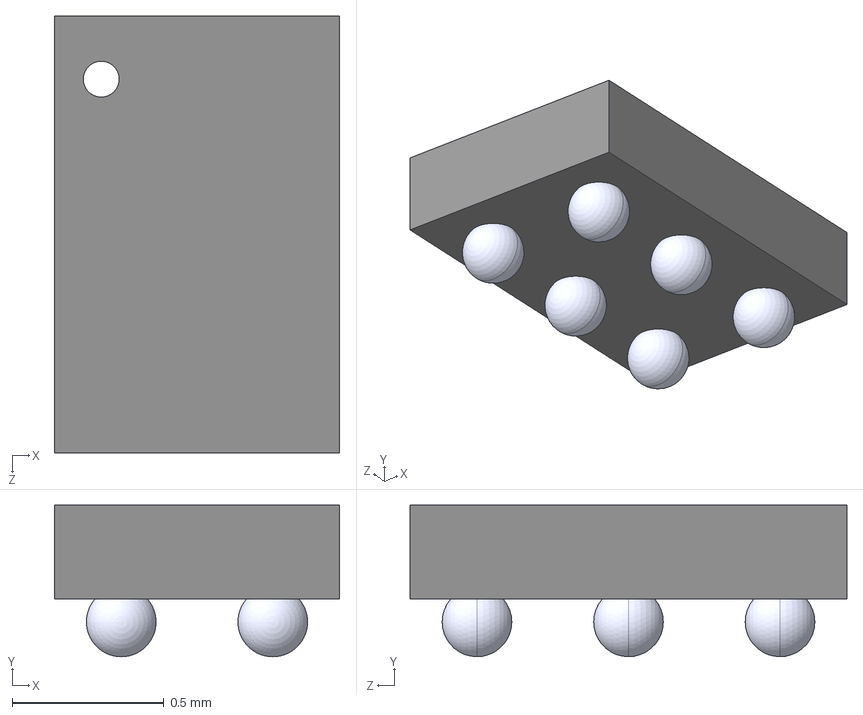
[picture p57: CAD file, 2024-08-12, last stored version]
3D Models/DSBGA-6.STEP
0.942 x 0.5 x 1.44 mm
