PicoballoonLabs/Hardware-Resources/3D Models/BALFLB-WL-XXXX.stp

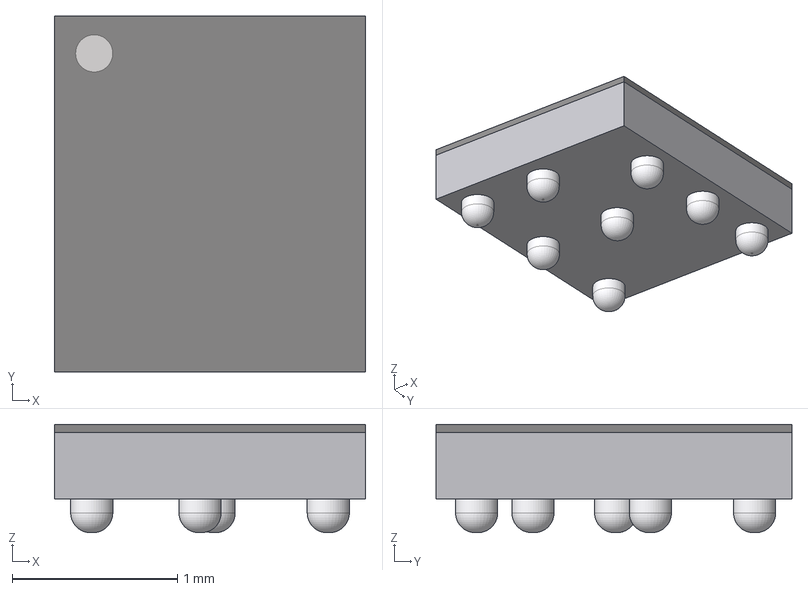
[picture p58: CAD file, 2024-08-12, last stored version]
3D Models/BALFLB-WL-XXXX.stp
1.88 x 2.15 x 0.655 mm
