PicoballoonLabs/Hardware-Resources/3D Models/ATSLP-10-50.stp

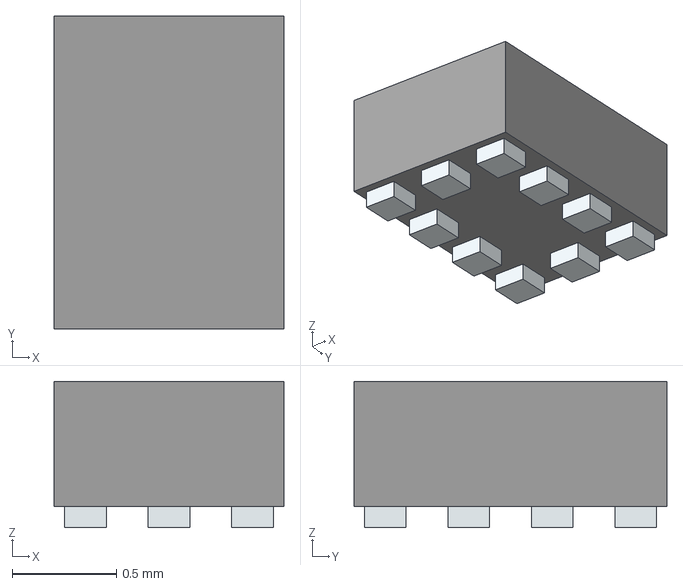
[picture p59: CAD file, 2024-08-12, last stored version]
3D Models/ATSLP-10-50.stp
1.10 x 1.50 x 0.7 mm
Pins
