PicoballoonLabs/Hardware-Resources/3D Models/S-LGA 53.STEP

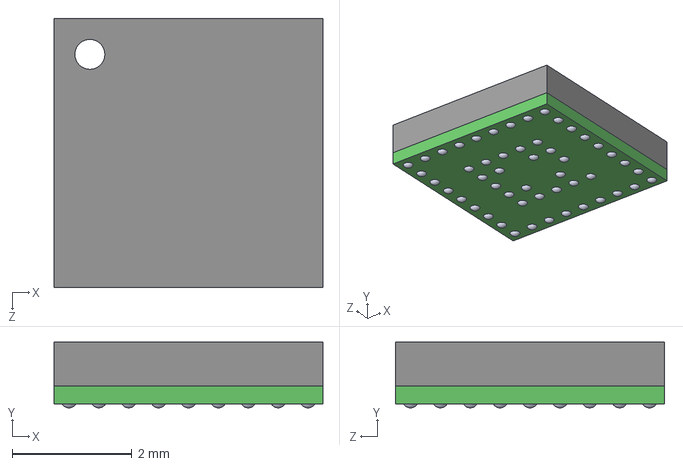
[picture p60: CAD file, 2024-08-12, last stored version]
3D Models/S-LGA 53.STEP
4.50 x 1.10 x 4.50 mm
