PicoballoonLabs/Hardware-Resources/3D Models/DFN-6 1x1.5mm.STEP

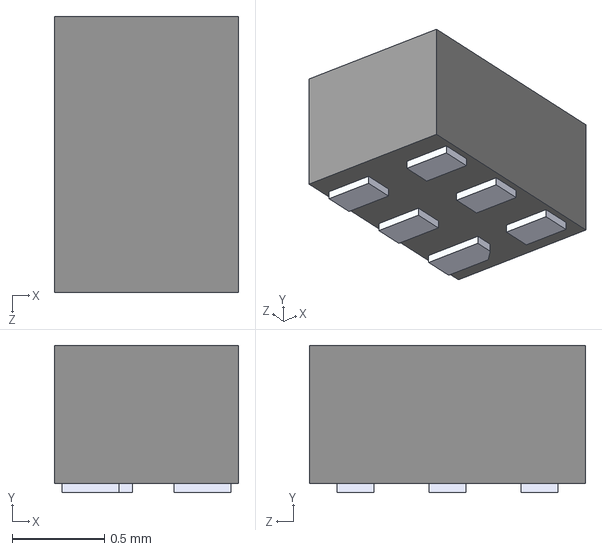
[picture p61: CAD file, 2024-07-15, last stored version]
3D Models/DFN-6 1x1.5mm.STEP
1.00 x 0.8 x 1.50 mm
