PicoballoonLabs/Hardware-Resources/3D Models/SMD2012-2P.STEP

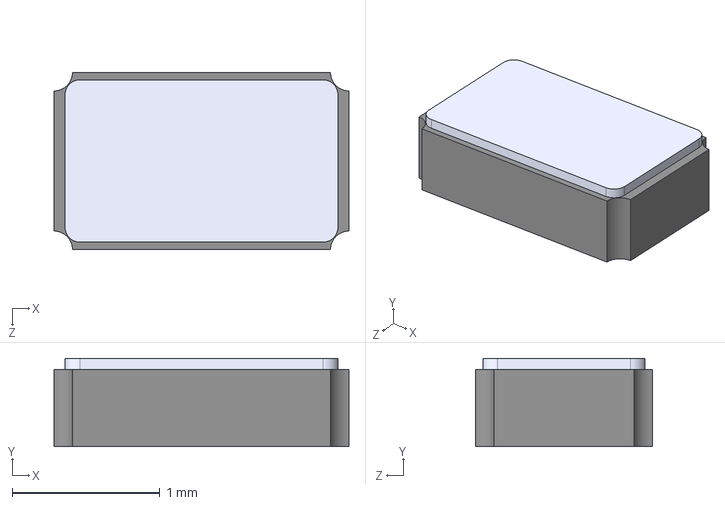
[picture p62: CAD file, 2024-07-15, last stored version]
3D Models/SMD2012-2P.STEP
2.00 x 0.6 x 1.20 mm
