PicoballoonLabs/Hardware-Resources/3D Models/QFN-40.stp

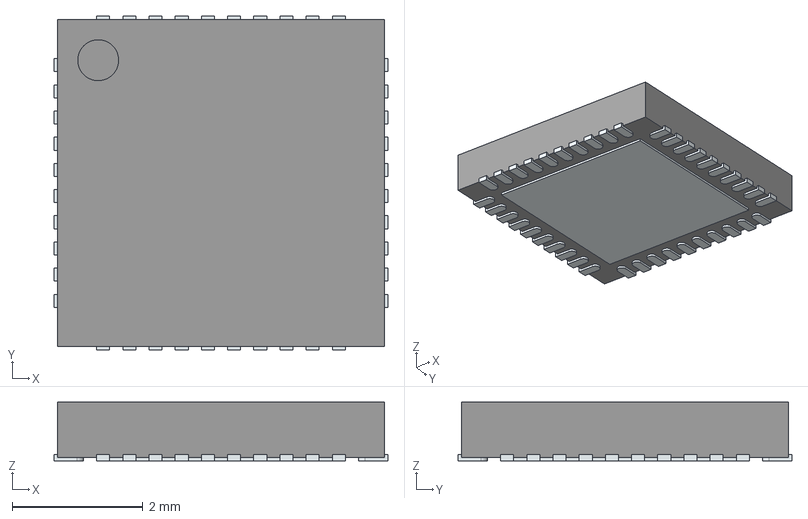
[picture p63: CAD file, 2024-07-15, last stored version]
3D Models/QFN-40.stp
5.10 x 5.10 x 0.9 mm
ThermalPin
PinsArrayLR
PinsArrayTB
