PicoballoonLabs/Hardware-Resources/3D Models/TCXO-2016.stp

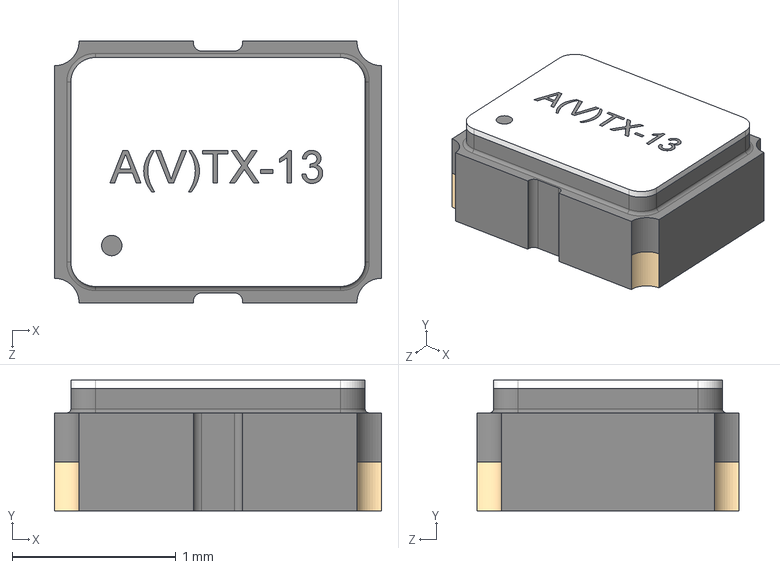
[picture p64: CAD file, 2024-07-15, last stored version]
3D Models/TCXO-2016.stp
2.00 x 0.801 x 1.60 mm
