PicoballoonLabs/Hardware-Resources/3D Models/DSBGA-4.stp

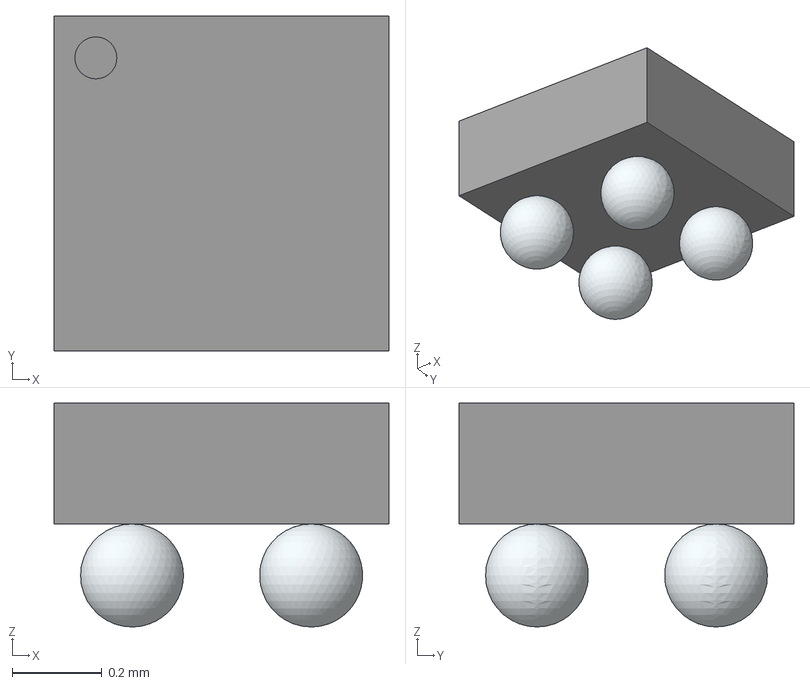
[picture p65: CAD file, 2024-06-23, last stored version]
3D Models/DSBGA-4.stp
0.748 x 0.748 x 0.5 mm
