PicoballoonLabs/Hardware-Resources/3D Models/ELV1411A.step

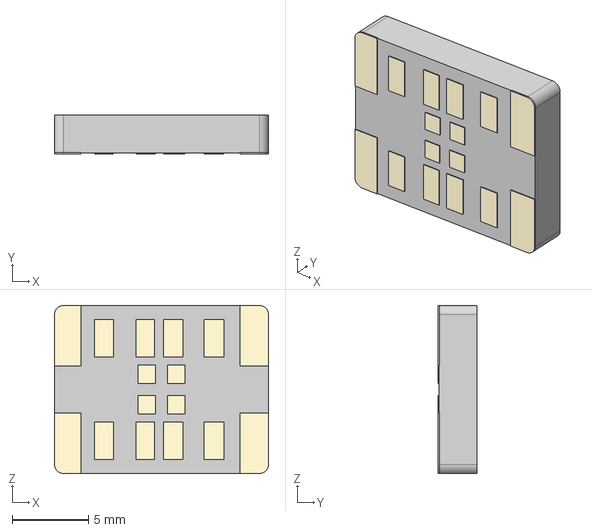
[picture p66: CAD file, 2024-06-23, last stored version]
3D Models/ELV1411A.step
14.0 x 2.55 x 11.0 mm
