PicoballoonLabs/Hardware-Resources/3D Models/Inductor 0402 Coil.STEP

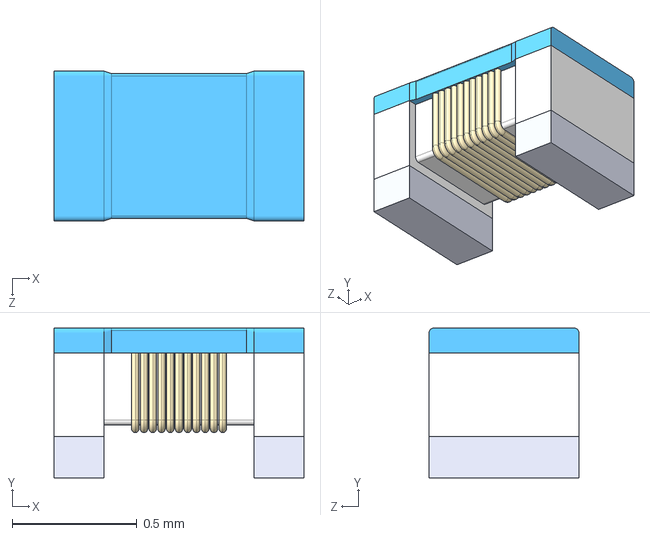
[picture p67: CAD file, 2024-06-21, last stored version]
3D Models/Inductor 0402 Coil.STEP
1.00 x 0.6 x 0.6 mm
