PicoballoonLabs/Hardware-Resources/3D Models/WS2812B-2020.STEP

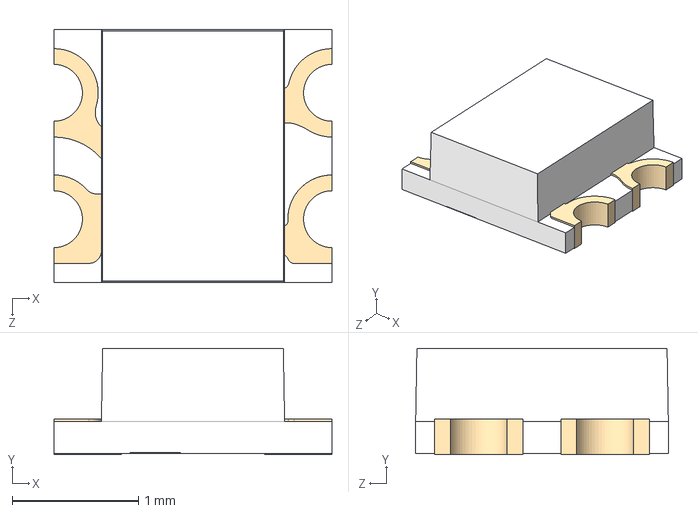
[picture p68: CAD file, 2024-06-20, last stored version]
3D Models/WS2812B-2020.STEP
2.20 x 0.84 x 2.00 mm
