PicoballoonLabs/Hardware-Resources/3D Models/DFN-4L.STEP

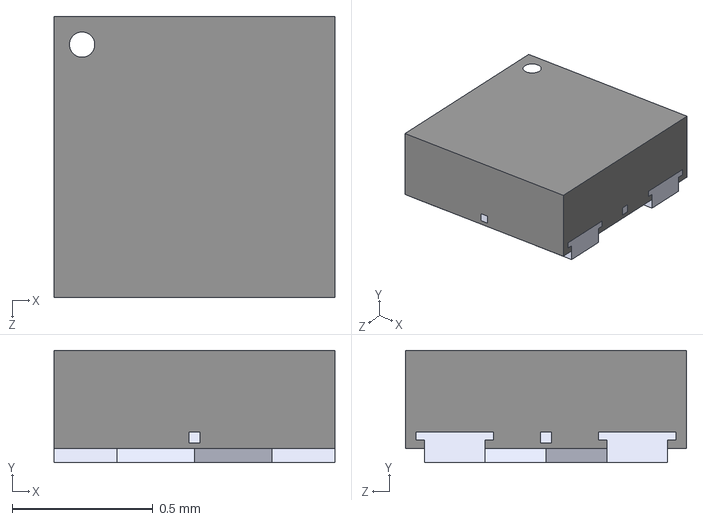
[picture p69: CAD file, 2024-06-20, last stored version]
3D Models/DFN-4L.STEP
1.00 x 0.4 x 1.00 mm
