PicoballoonLabs/Hardware-Resources/3D Models/PICOSTAR-3.STEP

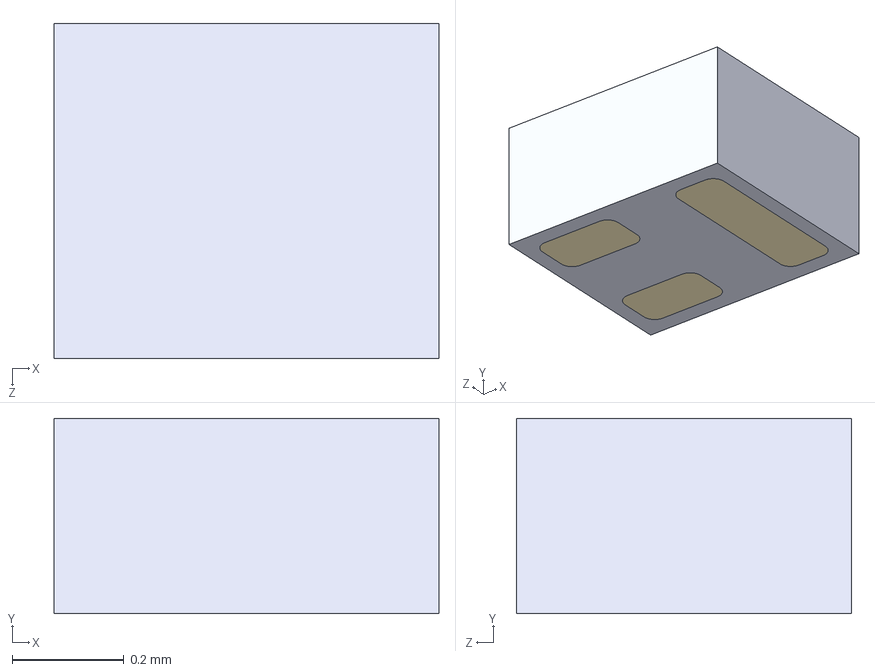
[picture p70: CAD file, 2024-06-20, last stored version]
3D Models/PICOSTAR-3.STEP
0.69 x 0.35 x 0.6 mm
