PicoballoonLabs/Hardware-Resources/3D Models/VFDFN-8.STEP

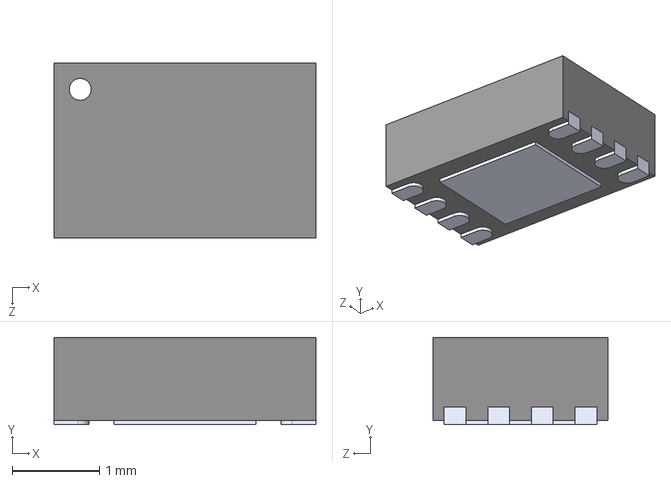
[picture p71: CAD file, 2024-06-20, last stored version]
3D Models/VFDFN-8.STEP
3.00 x 1.00 x 2.00 mm
