PicoballoonLabs/Hardware-Resources/3D Models/TYPE-C-31-M-12.STEP

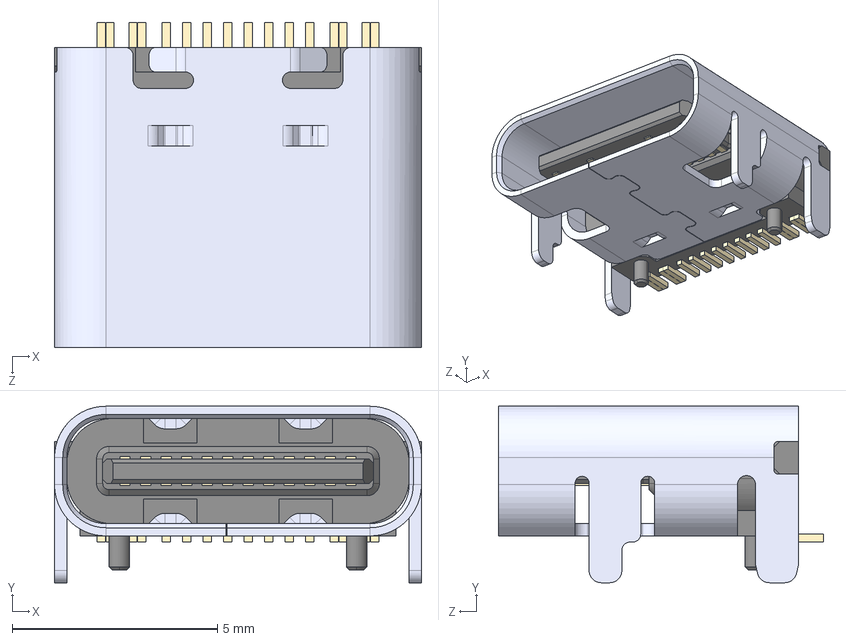
[picture p72: CAD file, 2024-06-20, last stored version]
3D Models/TYPE-C-31-M-12.STEP
8.94 x 4.30 x 7.90 mm
