PicoballoonLabs/Hardware-Resources/3D Models/QFN-12 3x3mm.stp

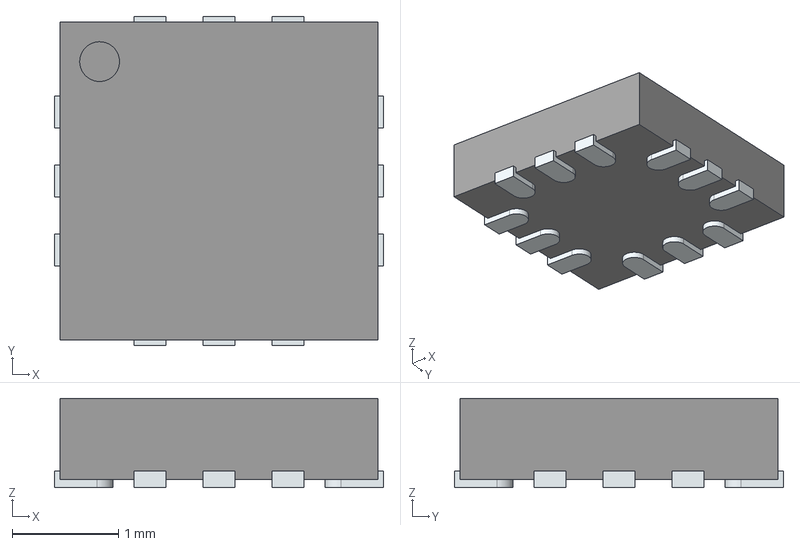
[picture p73: CAD file, 2024-06-18, last stored version]
3D Models/QFN-12 3x3mm.stp
3.10 x 3.10 x 0.84 mm
PinsArrayLR
PinsArrayTB
