PicoballoonLabs/Hardware-Resources/3D Models/NN02-201.step

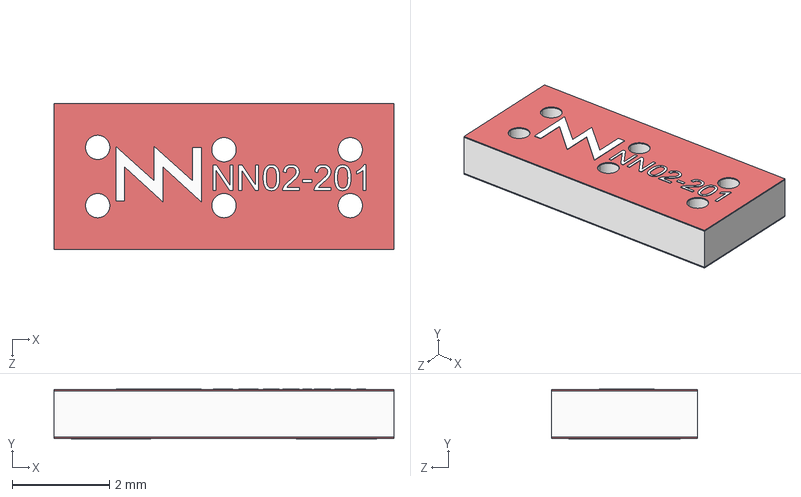
[picture p74: CAD file, 2024-06-18, last stored version]
3D Models/NN02-201.step
7.00 x 1.02 x 3.00 mm
