PicoballoonLabs/Hardware-Resources/3D Models/WSON-8 2x2mm.step

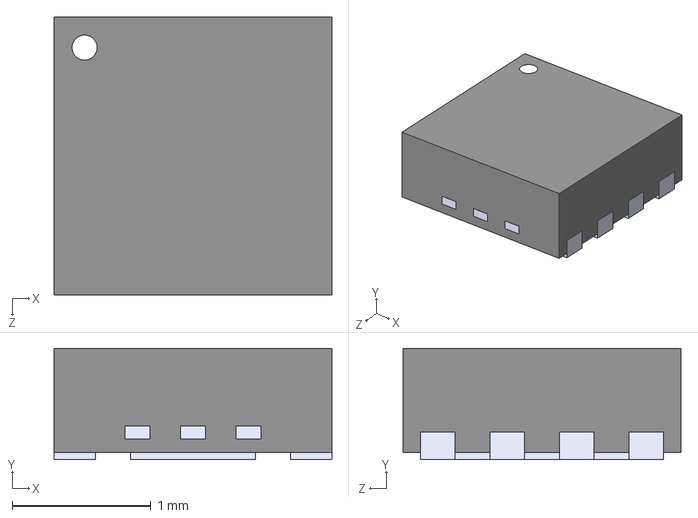
[picture p75: CAD file, 2024-06-18, last stored version]
3D Models/WSON-8 2x2mm.step
2.00 x 0.8 x 2.00 mm
