PicoballoonLabs/Hardware-Resources/3D Models/DSBGA-25.STEP

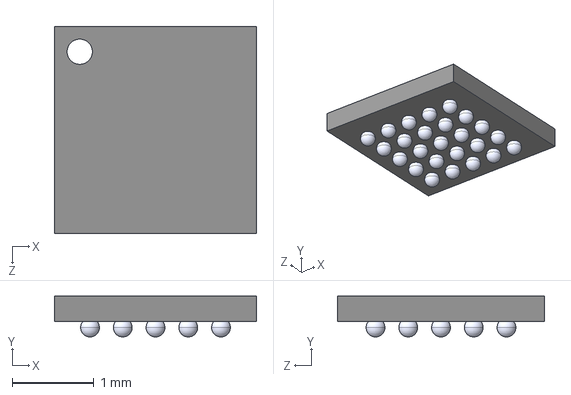
[picture p76: CAD file, 2024-06-18, last stored version]
3D Models/DSBGA-25.STEP
2.47 x 0.5 x 2.53 mm
