PicoballoonLabs/Hardware-Resources/3D Models/DFN0806-6.stp

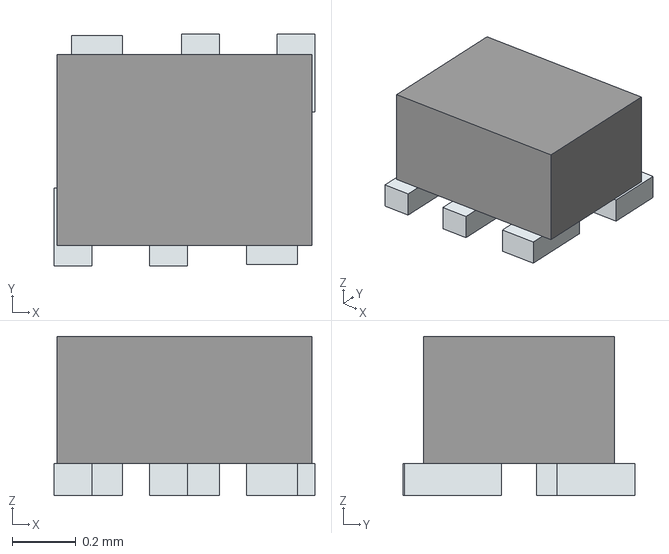
[picture p77: CAD file, 2024-06-18, last stored version]
3D Models/DFN0806-6.stp
0.82 x 0.729 x 0.5 mm
Pins
