PicoballoonLabs/Hardware-Resources/3D Models/EVQ-P7J01P.stp

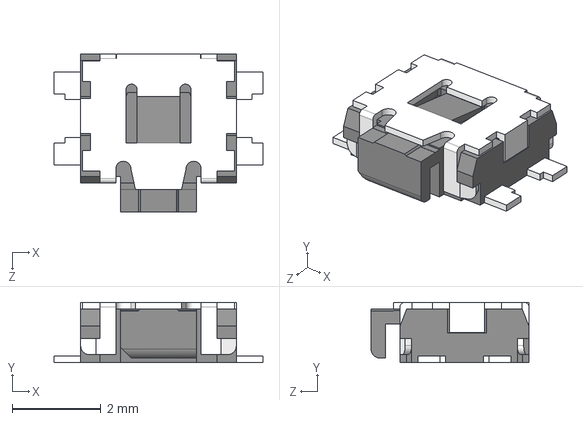
[picture p78: CAD file, 2024-06-18, last stored version]
3D Models/EVQ-P7J01P.stp
4.70 x 1.35 x 3.55 mm
