PicoballoonLabs/Hardware-Resources/3D Models/SHT45-AD1F-R2.stp

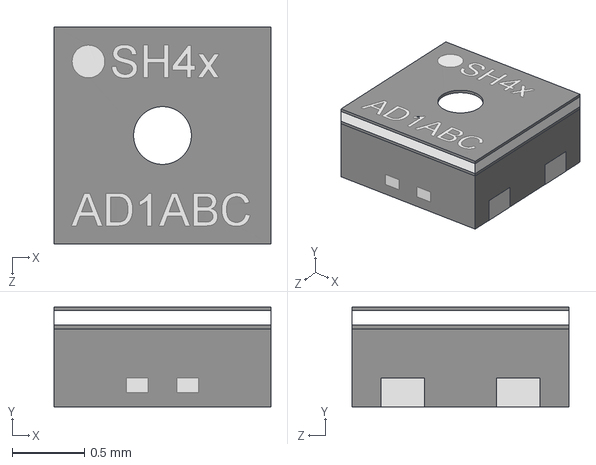
[picture p79: CAD file, 2023-09-13, last stored version]
3D Models/SHT45-AD1F-R2.stp
1.50 x 0.691 x 1.50 mm
