PicoballoonLabs/Hardware-Resources/3D Models/HMC03M.step

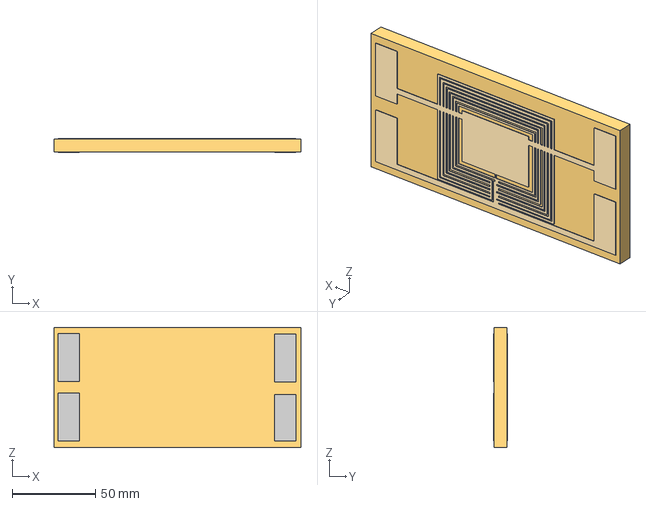
[picture p80: CAD file, 2023-09-13, last stored version]
3D Models/HMC03M.step
148.6 x 8.13 x 72.4 mm
