PicoballoonLabs/Hardware-Resources/3D Models/3D Model UFDFPN5.stp

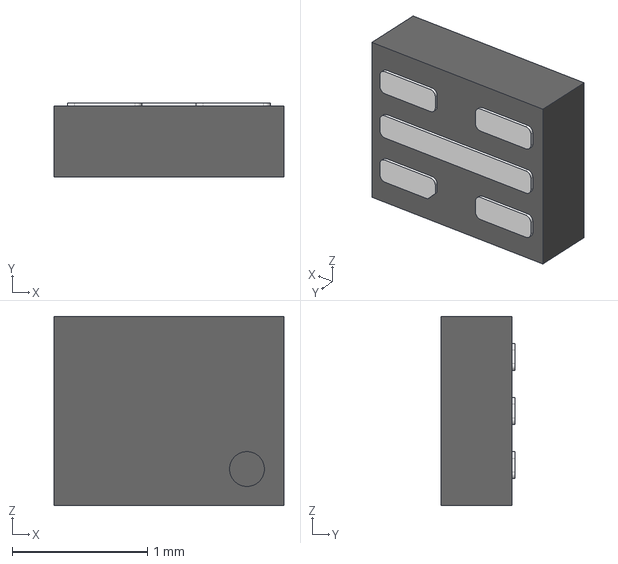
[picture p81: CAD file, 2023-09-13, last stored version]
3D Models/3D Model UFDFPN5.stp
1.70 x 0.55 x 1.40 mm
