PicoballoonLabs/Hardware-Resources/3D Models/MPRLS0300YG00001B.STEP

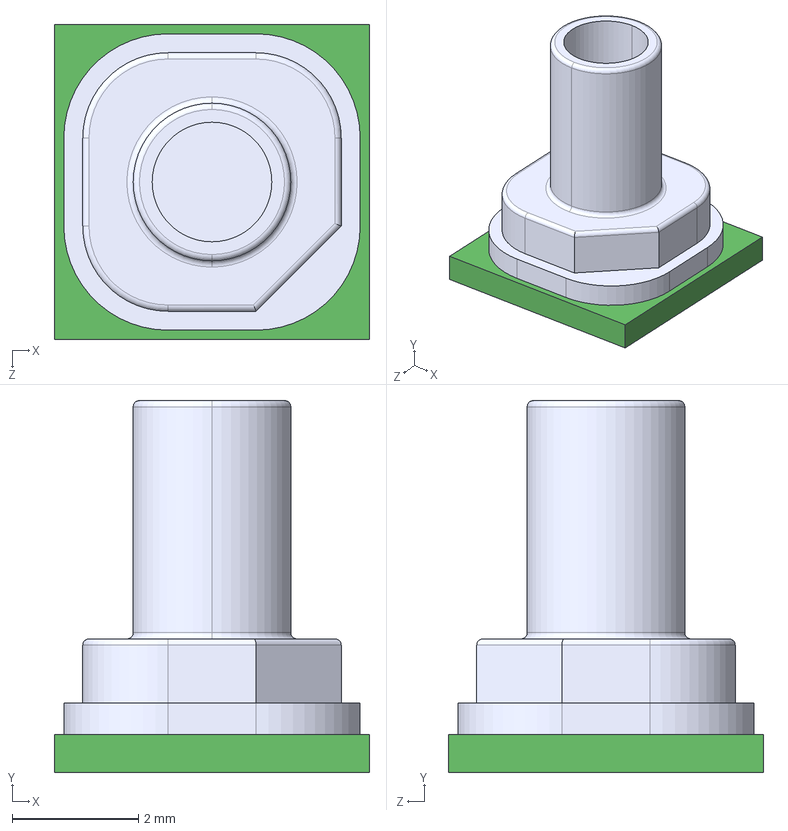
[picture p82: CAD file, 2023-08-15, last stored version]
3D Models/MPRLS0300YG00001B.STEP
5.00 x 5.90 x 5.00 mm
