PicoballoonLabs/Hardware-Resources/3D Models/CON-SOCJ-2155--3DModel-STEP-56544.STEP

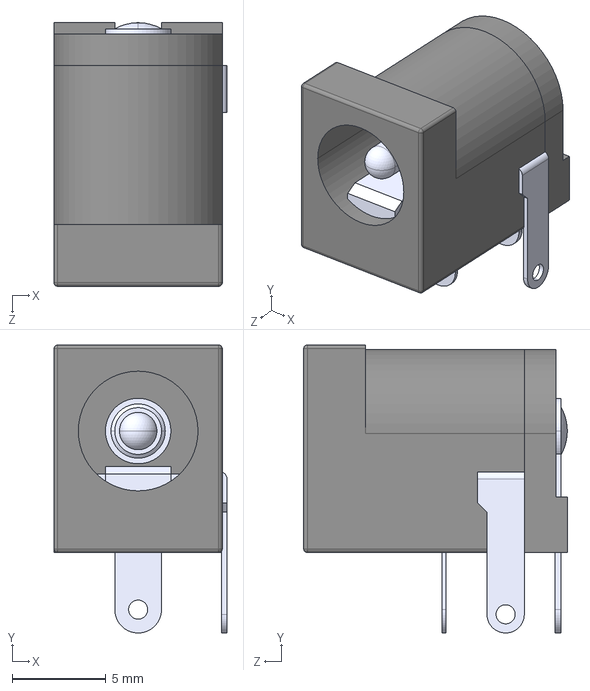
[picture p83: CAD file, 2023-08-15, last stored version]
3D Models/CON-SOCJ-2155--3DModel-STEP-56544.STEP
9.25 x 15.4 x 14.1 mm
