PicoballoonLabs/Hardware-Resources/3D Models/DX07S016JA1R1500--3DModel-STEP-1.STEP

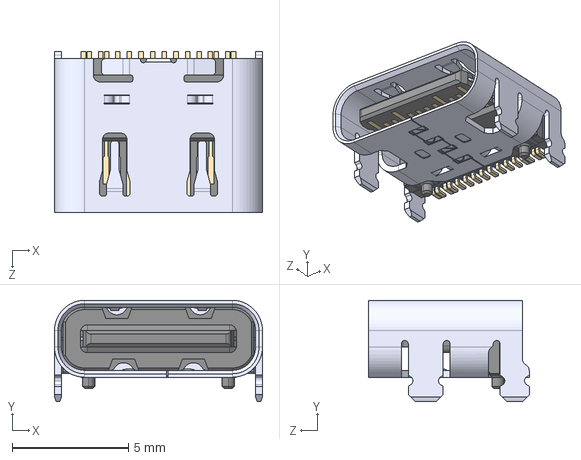
[picture p84: CAD file, 2023-08-15, last stored version]
3D Models/DX07S016JA1R1500--3DModel-STEP-1.STEP
8.94 x 4.36 x 6.90 mm
