PicoballoonLabs/Hardware-Resources/3D Models/STD3NM60N.stp

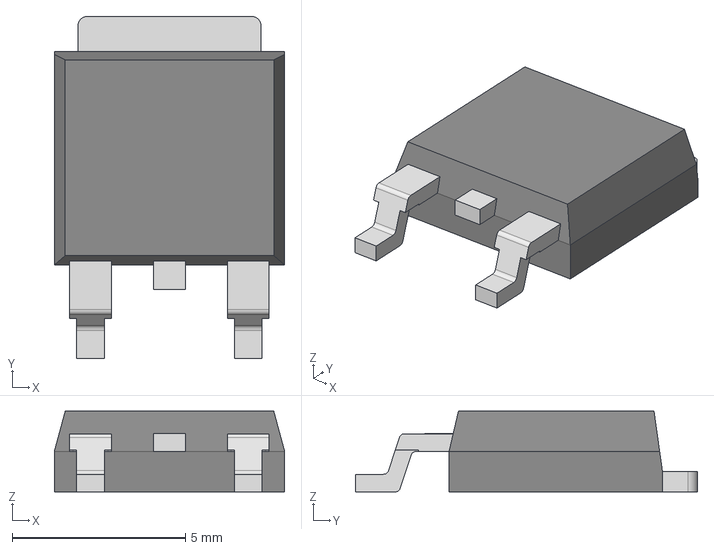
[picture p85: CAD file, 2023-08-15, last stored version]
3D Models/STD3NM60N.stp
6.65 x 9.87 x 2.33 mm
