PicoballoonLabs/Hardware-Resources/3D Models/AZ1117CH2-3.3TRG1.stp

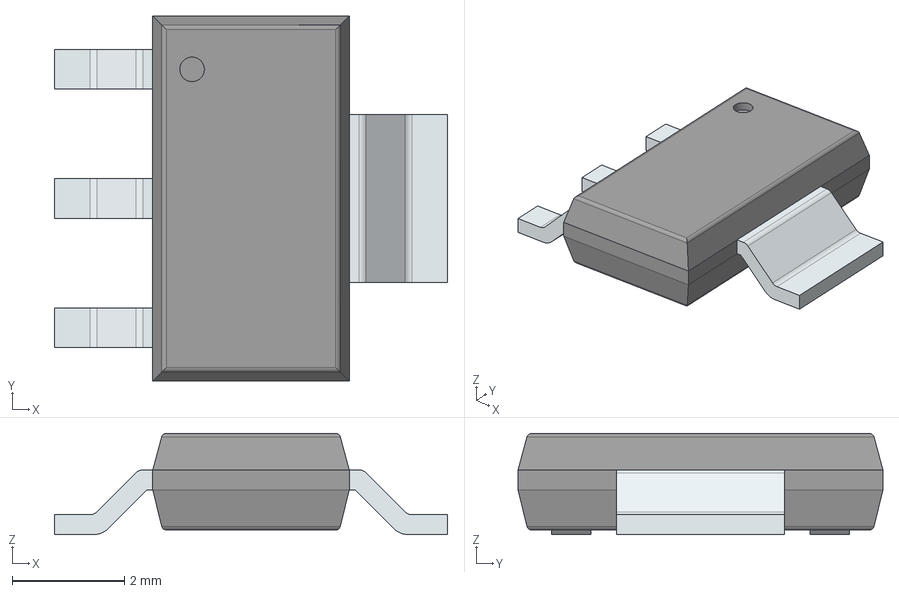
[picture p86: CAD file, 2023-08-15, last stored version]
3D Models/AZ1117CH2-3.3TRG1.stp
7.00 x 6.50 x 1.80 mm
PinsArrayL
FilletPinR
