PicoballoonLabs/Hardware-Resources/3D Models/CP2102N-A01-GQFN20.STEP

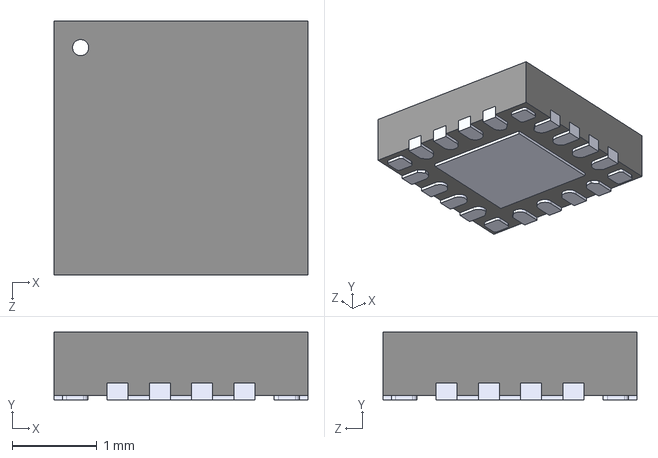
[picture p87: CAD file, 2023-08-15, last stored version]
3D Models/CP2102N-A01-GQFN20.STEP
3.00 x 0.8 x 3.00 mm
