PicoballoonLabs/Hardware-Resources/3D Models/QFN-48-1EP_7x7mm_P0.5mm_EP5.3x5.3mm.step

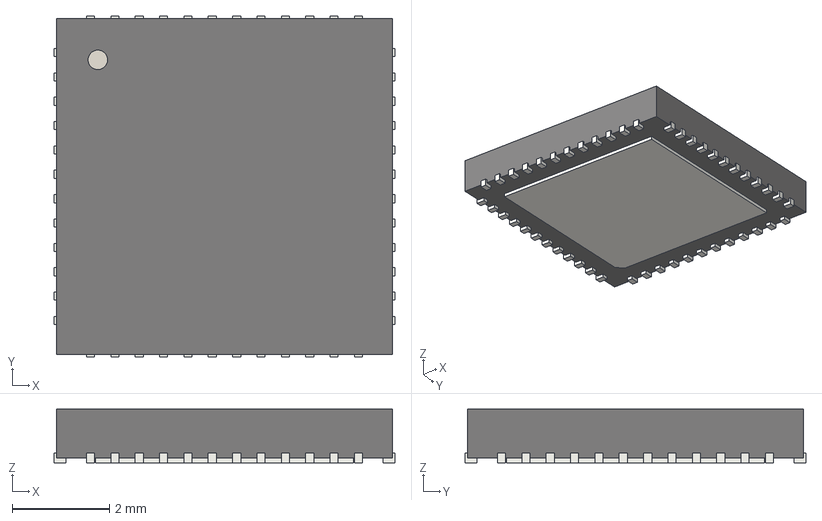
[picture p88: CAD file, 2023-08-15, last stored version]
3D Models/QFN-48-1EP_7x7mm_P0.5mm_EP5.3x5.3mm.step
7.00 x 7.00 x 1.10 mm
