PicoballoonLabs/Hardware-Resources/3D Models/CP2102N-A02-GQFN24R.stp

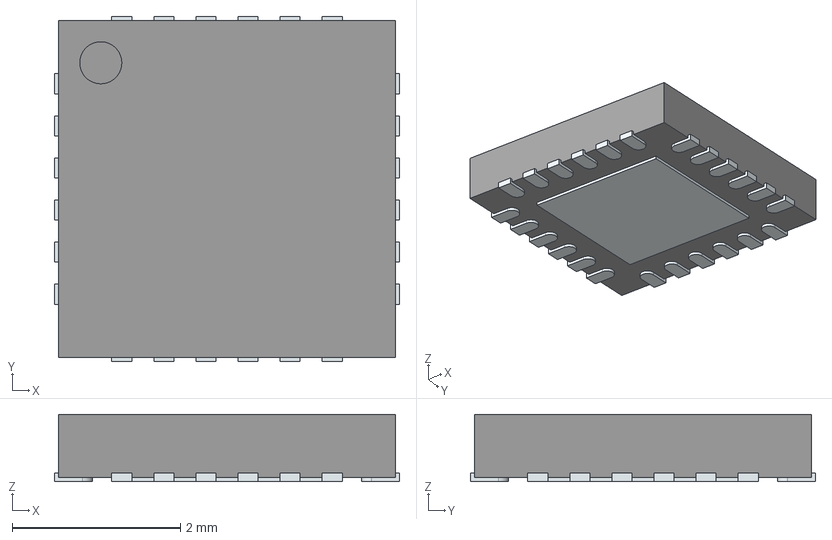
[picture p89: CAD file, 2023-08-15, last stored version]
3D Models/CP2102N-A02-GQFN24R.stp
4.10 x 4.10 x 0.8 mm
ThermalPin
PinsArrayLR
PinsArrayTB
