PicoballoonLabs/Hardware-Resources/3D Models/SSM3K72KCT,L3F.stp

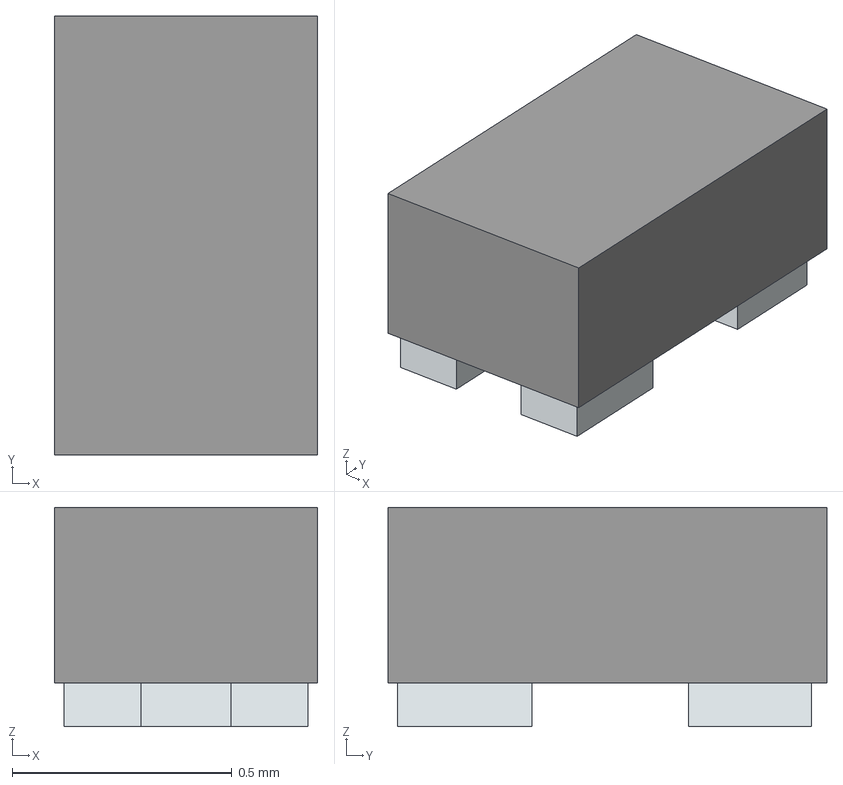
[picture p90: CAD file, 2023-08-15, last stored version]
3D Models/SSM3K72KCT,L3F.stp
0.6 x 1.00 x 0.5 mm
Pins
