PicoballoonLabs/Hardware-Resources/(list of files, cad)

Other CAD files:
3D Models/VQFN-HR-12.STEP
3D Models/WSON-6 2x2mm.step
3D Models/104224-0820.step
3D Models/1985849.stp
3D Models/2454985-3.stp
3D Models/470531000.stp
3D Models/505110-0692.stp
3D Models/505110-1097.stp
3D Models/6530027.STEP
3D Models/GRP4435035.stp
3D Models/GRP4730026.STEP
3D Models/MAX17048G+T10.STEP
3D Models/MS561101BA03-50.stp
3D Models/QFN-16.stp
