PicoballoonLabs/Hardware-Resources/(commit log)

2023-08-15 Add ICs, Power Symbols and Mechanical Libraries and 3D models
    [1985849.stp, AZ1117CH2-3.3TRG1.stp, CON-SOCJ-2155--3DModel-STEP-56544.STEP, CP2102N-A01-GQFN20.STEP, CP2102N-A02-GQFN24R.stp, DX07S016JA1R1500--3DModel-STEP-1.STEP, DX07S016JA1R1500.step, MPRLS0300YG00001B.STEP]
2023-08-15 Hide labels in footprints by default
2023-08-16 Add basic resistors and capacitors
2023-09-13 Update sensor footprints, add 3D models
    [3D Model UFDFPN5.stp, DX07S016JA1R1500--3DModel-STEP-1.STEP, HMC03M.step, SHT45-AD1F-R2.stp]
2023-09-14 Add PCAP04 and FPC connector footprints and 3D models
    [505110-1097.stp]
2023-09-15 New FPC and FPC connectors
    [505110-0692.stp]
2024-06-18 Add batteries & Vibraball ICs
    [6530027.STEP, DFN0806-6.stp, DSBGA-25.STEP, EVQ-P7J01P.stp, GRP4435035.stp, NN02-201.step, QFN-12 3x3mm.stp, QFN-16.stp]
2024-06-20 Add mosfet, battery ICs, diode & LED
    [DFN-4L.STEP, MAX17048G+T10.STEP, PICOSTAR-3.STEP, TYPE-C-31-M-12.STEP, VFDFN-8.STEP, WS2812B-2020.STEP]
2024-06-21 Improve ICs & RF Passives
    [Inductor 0402 Coil.STEP]
2024-06-22 Modify USB connector positioning for P&P
2024-06-23 Add load switch & LRA 3D model
    [DSBGA-4.stp, ELV1411A.step]
2024-06-24 Fix P&P rotation, improve GRP battery
    [GRP4730026.STEP]
2024-06-29 Add 0402L footprint
2024-07-15 Update packages
    [DFN-6 1x1.5mm.STEP, QFN-16.stp, QFN-40.stp, SMD2012-2P.STEP, TCXO-2016.stp]
2024-08-12 Update models
    [ATSLP-10-50.stp, BALFLB-WL-XXXX.stp, DSBGA-6.STEP, Diode 0201.STEP, S-LGA 53.STEP, TSNP-6-10.step]
2024-10-03 Add USB bridge & MUX IC
    [UQFN-10.stp]
2024-10-06 Add power mosfet, 2-CH LDO & connector
    [B2B-XH-A (LF)(SN).STEP, TSDSON-8.STEP, WSON-10 2x2mm.stp]
2024-10-07 Update models for PCBA
2024-10-08 Add SWD connector
    [2454985-3.stp, SWD 2x5 Box Connector.step, SWD 2x5 Mini Connector.step]
2024-10-10 Add new LDOs, MOSFET & connectors
    [20021521-00010T1LF.step, FTSH-105-01-L-DV-K-TR.step, X2-DFN1010-3.stp]
2024-11-04 Add NRF9161, update passives
    [Inductor 0201.STEP, NRF9161.STEP]
2024-11-05 Add SIM card connector & 4P socket
    [104224-0820.step, WAFER-XH2.54-4PWB.stp]
2024-11-05 Add SMA connector & SMB diode
    [Diode SMB.step, SMA_EDGE.step]
2024-12-01 Add solar cell & solar panel connector
2024-12-14 Add power MUX and DC/DC
    [VQFN-HR-12.STEP]
2024-12-27 Add GNSS LNA, update SMA connector
    [BWSMA-KE-P001.stp]
2025-02-13 Improve NRF9161 package, add RF connector, update packages
    [MM8030-2610RK0.step, QFN-16.stp]
2025-04-03 Add battery holder, button, LED, battery ICs, polarized cap
    [Battery holder BH-18650-B1BA002.stp, Button GT_TC029B-H025-L1N.stp, LED WS2813B-MINI-V1.STEP, VFQFN-29.STEP, VSON-10 3x3mm.STEP]
2025-04-03 Add smaller LED
    [LED WS2816B-2121.STEP]
2025-04-04 Add diode and new DCDC
    [VQFN-11.STEP]
2025-04-04 Upgrade to higher power DCDC
    [Inductor 7678.stp]
2025-04-07 Add board to board connectors
    [B2B GT-B0353FSV06-06B0201.stp, B2B GT-B0353FSV06-08B0201.stp, B2B YXT YXT-BB10-10S-02.STEP, FPC-05F-10PH20.stp, MOLEX 532610271.STEP]
2025-04-07 Improve B2B connector headers
2025-04-09 Update passives & B2B connectors
    [B2B GT-B0353MSV04-06B0201.stp, B2B GT-B0353MSV04-08B0201.stp, B2B YXT-BB10-10P-02.stp, Inductor 1008.stp]
2025-04-14 Add large connector
    [XT60PW-F.STEP]
2025-04-16 Improve footprint manufacturability
2025-04-17 Fix FET symbols
    [Inductor 3x3mm.stp]
2025-06-23 Update components for YourLox 4.1
    [Capacitor 6.3x5.9mm.STEP, DC-005-5A-2.5-SMT.stp, DFN-6 2x2mm.stp, Inductor 5553.stp, Polyfuse 1206.STEP, Polyfuse 2018.stp, QFN-16 4x4mm.step, WS2812B-MINI-X2.stp]
2025-06-29 Fix inductor silkscreen
2025-07-11 Add capacitors
2025-07-18 Update components for YL V4.2
    [HPAK-7.step, Inductor 6466.stp, Polyfuse 1210.STEP, VFQFN-HR-11.STEP, VQFN-HR-10.step, WAFER-XH2.54-2PWB.stp, WSCP-8.STEP]
2025-07-21 Update fuses
    [Fuse 1206.STEP, Polyfuse 1812.STEP, Polyfuse 2920.STEP]
2025-07-23 Update battery model
2025-07-29 Update YourLox components
    [470531000.stp, Inductor 1620.stp, VSON-HR-10.step]
2025-08-11 feat!: major refactor - KiCad package repository - Separate lib packages
2025-08-12 fix: merge sensor board additions
2025-08-14 Cleanup symbols and footprints
2025-08-14 Update for calib board
2025-08-15 Component updates for BMS
2025-08-20 Update FPC connector shield
2025-08-21 Updated connector to XUNPU FPC-05F-10PH20
2025-08-21 Revert "Updated connector to XUNPU FPC-05F-10PH20"
    This reverts commit 7e7bc85a608a74281debc2882263625ef2bae5cb.
2025-08-23 Update from sensor board
2025-08-23 Add HYT.R411 sensor
2025-08-24 Custom resistor array package
2025-08-24 Update LED, add button 3D model
2025-08-24 Update sensor board components
2025-09-06 added 24V
2025-09-08 Added RJ-45 footprint
2025-09-08 Added Inductor 3.9x3.9mm footprint
2025-09-08 Small touches to footprints and symbols
2025-09-09 Update BMS components
2025-09-09 Fix UART converter symbol
2025-09-09 Update UART converter
2025-09-10 BMS footprint updates
2025-09-10 feat: add WS2812B-2121 led
2025-09-23 imported G-Switch GT-TC048D-H025-L1
2025-09-28 Improvements to symbols in probe
2025-09-29 esd5Z diode symbol added
2025-09-30 component symbols updated, added some footprints for dcdc converter,ina...
2025-10-01 added 0402 diode
2025-10-01 Added Double battery symbol
2025-10-01 battery update and temporary connector fix
2025-10-01 Minor footprint fix
2025-10-02 updated batt symbols and linked some footprints
2025-10-02 symbol parameters/footprint update
2025-10-02 fixed battery aaa step and testpoint
2025-10-05 Updated antenna layouts
2025-10-06 nn02 antenna pad update
2025-10-08 Antennas update-mask and rule areas resize
2025-10-08 antennas errorfix3
2025-10-15 konecne spravna soldermaska-anteny
2025-10-15 gps antenna pad short fixed
2025-10-21 Round connector pads
2025-10-22 dbg connector pins added
2025-10-22 nn02-201 antenna efficiency updated/fixed footprint
2025-10-22 nn02-201 double footprint fix
2025-10-28 Update pressure sensor
2025-10-28 honeywell pressure sensor
2025-10-29 Add 4P fpc cable
2025-10-29 4p symbol with mounting pad
2025-10-29 Update MS5611 pressure sensor
2025-10-29 connector update
2025-10-29 Update connector
2025-11-03 0402 diode footprint added
2025-11-04 Cleanup footprints
2025-11-04 Update footprints for assembly
2025-11-05 Fix footprint 3d models
2025-11-13 Passive symbols updated nad fixed(all)
    designators,desctiprion, rotation pin numbers...
2025-12-03 added level translators and led symbol
2025-12-09 8p connector fixed
2025-12-09 8pin hirose connector added
2025-12-09 BH-AAA 2mm spacing increased
2025-12-09 FFC connector 8pin vertical added, no 3d model
2025-12-09 fpc8 connector update
2025-12-14 Sensor board component update
2025-12-15 footprints update led, level translator connector
2025-12-17 Added footprints
2025-12-18 renamed pins on connector
2025-12-18 Update debug connector keepout
2025-12-22 reduced padsize in 8pin connector
2025-12-22 FD-11 footprint cleanup
2025-12-22 Updates from calibration board
2025-12-23 led footprint fix and programming connector layout update
2025-12-24 Improve battery holder footprint
2025-12-24 Update pin specifications
2025-12-24 Split battery into 2 parts
2025-12-24 Fix battery alignment
2026-01-07 added stm32g03mcu and ads1220adc
2026-01-08 chinese cap driver added,ads1220 updated
2026-01-08 updated stm32g031 and ads1220
2026-01-12 imported STM32G031G8U6
2026-01-12 Fix sensor board packages
2026-01-12 Update Picoballoon ICs.kicad_sym
    ics updated with LCSC Part # field(without parameters
2026-01-14 Sensor board improvements
2026-01-15 FPC cable 8pin 1mm shorter
2026-01-15 FPC cable shortened, dfn footprint updated,removed bottom layers
2026-02-16 Universal TVS unidir diode added
2026-02-16 LED footprint updated
2026-02-17 murata lowpass filter footprint created
2026-02-17 molex 8p connector added
2026-02-19 BALFB filter zones update
2026-03-02 Update DSBGA-4.kicad_mod
    dsbga clearance update
2026-03-03 max17222 added correct footprint
2026-03-03 Update probe schematic symbols
2026-03-06 Calibration array symbols/footprints update
2026-03-06 8pin connector update
2026-03-08 Calibration board symbols update
2026-03-08 Update calibration board symbols
2026-03-09 stm32u073 added
2026-03-09 Probe component fixes
2026-03-18 added gxht40AD, added 18V loadswitch
2026-03-18 GXHT footprint added
2026-03-19 simholder_flip footprint+symbol
2026-03-26 updated ADC and connector
2026-03-27 IDBG PCB components
2026-04-01 Wson switch footprint added
2026-04-08 Button courtyard
